erenozgurdogan/HighGain_DC-DC_Converter/Images/ExperimentalResults/experimentalresult.png

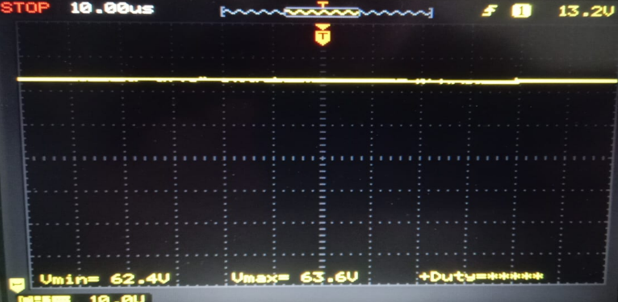
Images/ExperimentalResults/experimentalresult.png
