erenozgurdogan/HighGain_DC-DC_Converter/reports/erenozgur_dogan_2020502022.pdf

T.C.
DOKUZ EYLUL UNIVERSITY
ENGINEERING FACULTY
ELECTRICAL & ELECTRONICS ENGINEERING DEPARTMENT

## AN IMPROVED NON-ISOLATED QUADRATIC

## DC–DC BOOST CONVERTER WITH ULTRA

## HIGH GAIN ABILITY

### Fall Semester Report

by

### Eren Özgür DOĞAN

## Advisor

### Prof. Dr. Eyüp Akpınar

December, 2024

IZMIR

### TABLE OF CONTENTS

### 1.1 Enhanced Renewable Energy and Voltage Gain Improvement with Power Electronics .4

### ÖZET

Bu raporda, izole olmayan bir karesel yükseltici dönüştürücü tanıtmaktadır. "İzole

olmayan" terimi, giriş ve çıkış arasında elektriksel bir izolasyonun bulunmadığını ifade eder,

bu da devreyi daha basit ve verimli hale getirirken, güvenliği azaltır. "Karesel" terimi, giriş ve

çıkış gerilimi arasındaki ilişkiyi ifade eder ve bu parametrik ilişki içerisinde kareli bir çalışma

döngüsü vardır. Önerilen dönüştürücü, giriş gerilimini yükselten bir devrenin ardışık olarak

kurulumu yapısını kullanmadan ultra-yüksek çıkış gerilimi kazancını tek ve bütünleşik bir

devre yapısı ile elde etme özelliğine sahiptir. Düşük bir çalışma döngüsü ile yüksek çıkış

gerilim kazancı sağlar. Devre içerisinde bulunan kapasitörler, diyotlar ve yarı iletken

anahtarlar üzerinde gerilim stresini azaltılmaktadır. Ayrıca, sürekli kaynak akımı (CSC) ve

giriş-çıkış tarafı toprak paylaşımı özellikleri, yenilenebilir enerji uygulamaları için de

uygulamada | avantajlar sağlar. | Dönüştürücünün performansı, benzer topolojilerle

karşılaştırılmış ve teorik performans analizi yapılmıştır. Matlab/Simulink'ten elde edilen

simülasyon sonuçları, parametrik eşitliklerden çıkarılan teorik sonuçlarla karşılaştırılmıştır.

### ABSTRACT

This report introduces a non-isolated quadratic boost converter. The term "non-isolated"

indicates that there is no electrical isolation between the input and output, which simplifies the

circuit and increases efficiency while reducing safety. The term "quadratic" refers to the

relationship between the input and output voltage, characterized by a squared duty cycle within

this parametric relationship. The proposed converter achieves ultra-high output voltage gain

with a single and integrated circuit structure, without the sequential setup of circuits that step

up the input voltage. It provides high output voltage gain with a low duty cycle. Voltage stress

on the capacitors, diodes, and semiconductor switches within the circuit is reduced.

Additionally, features such as continuous source current (CSC) and input-output ground

sharing offer practical advantages for renewable energy applications. The converter's

performance has been compared with similar topologies, and a theoretical performance

analysis has been conducted. Simulation results obtained from MATLAB/Simulink have been

compared with theoretical results derived from parametric equations.

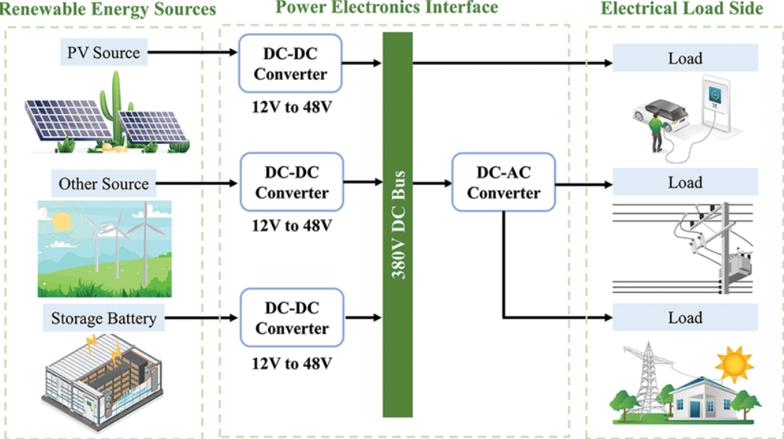
[picture p2: figure]

Figure 1 Power Electronics Interface

### 1. INTRODUCTION

### 1.1 Enhanced Renewable Energy and Voltage Gain Improvement with Power

Electronics

The excessive consumption of fossil energy sources leads to an increase in harmful gases

and climate change. This situation has led to a greater focus on renewable energy sources and

strengthened the need for sustainable energy solutions. Power electronics and converter

technologies are key tools that support this transition, ensuring that power obtained from

renewable energy sources is transferred efficiently to the energy grid.

The most fundamental topologies of boost and buck-boost converters can increase the low

input voltage to the required level using pulse width modulation (PWM) control. However,

conventional topologies cannot meet the voltage boosting requirements of real-time

applications. To achieve higher voltage gain, converters must operate at a high duty cycle.

However, this leads to an increase in voltage stress on the circuit components.

DC-DC boost converters can be classified into isolated and non-isolated types. Isolation is

typically achieved via a transformer, which increases the system's safety, but also makes the

system more complex, bulky, and costly.

The proposed circuit features CSC (Continuous Source Current) and SG (Shared

Ground) properties. CSC means that the input current in the circuit is continuous and stable,

which ensures more stable and efficient operation of the system. SG refers to the common ground connection shared by all components in the circuit, which enhances both safety and

efficiency.

The main features of the proposed topology are as follows:

Ultra-high voltage gain with low voltage stress on the devices.

CSC and SG features.

Same PWM used for both switches ,resulting in simpler control.

Fewer components and lower voltage stress compared to other ultra-high gain topologies.

### 2. METHOD

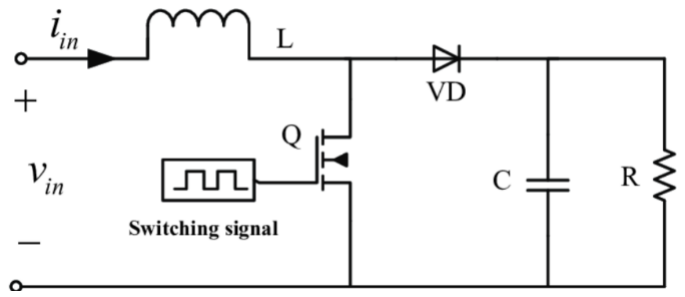
[picture p3: figure]

Figure 2.1 Conventional topology”

### 2.1 Switch (MOSFET) ON State

When the switch (MOSFET) is ON, the input voltage is applied to the inductor. This causes

the magnetic field in the inductor to increase and energy to be stored in the inductor. Current

flows only through the inductance. The magnetic field in the inductor converts electrical

energy into magnetic energy. During this time, the current in the inductor increases at a

constant rate, as the inductor opposes the change in current (L diI/dt).

### 2.2 Switch (MOSFET) OFF State:

When the switch is turned OFF, the MOSFET is deactivated and the inductor is removed

from the circuit. The magnetic field in the inductor tends to collapse, releasing the energy it

has stored. Due to the high inductance, the change in current is opposed, preventing an abrupt

change, and causing the magnetic field to start collapsing. As the magnetic field collapses, the stored energy in the inductor is directed through the diode to the output. While the current

decreases slowly, there are voltage changes during this process. The current is released from

the inductor and decreases gradually through the conduction of the diode.

Each component in the circuit has a specific function.

Diode: When the switch is OFF, the diode allows current to flow only towards the output,

thereby directing the stored energy to the output. This prevents reverse current flow and

ensures that energy from the inductor is released in the correct direction.

Capacitor: The capacitor reduces voltage fluctuations at the output and stabilizes the

output voltage. It smoothens the variations by storing and releasing energy, helping to maintain

a more consistent voltage.

Switch (MOSFET or Transistor): Typically, a MOSFET or transistor is used as a switch

in the circuit. When the switch is ON, it allows current to flow through the inductor, storing

energy in its magnetic field. When the switch is OFF, it stops the current, and the inductor

releases its stored energy to the output through the diode.

The output voltage for the boost converter depends only on the input voltage and duty cycle

Vout =

Vin
1−D

D =

Ton
Ton+Toff

Duty cycle is controlled by microcontrollers. Microcontrollers generate PWM (Pulse Width

Modulation) signals and adjust the operating times of the switches, thus controlling the duty

cycle. Ton refers to the time the switch is conducting, while Toff refers to the time the switch

is off. Ton+ Toff constitutes one period.

In a traditional boost converter, a high duty cycle must be set to achieve high voltage gain.

However, a high duty cycle leads to lower efficiency, higher voltage stress, and instability and

insecurity at high voltages. Therefore, more modern topologies are preferred over traditional

ones.

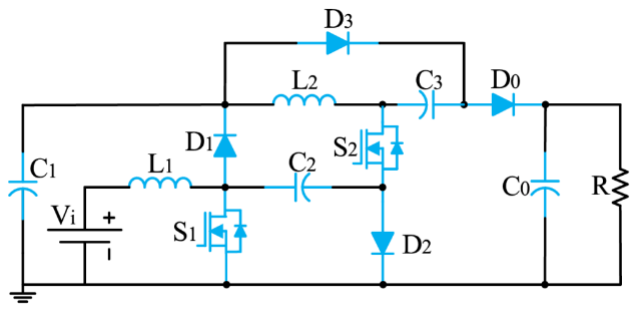
[picture p4: figure]

Figure 2.2 Proposed converter

The proposed converter achieves ultra-high gain without VDC with 12 components in Figure 2.2[1]. Compared with other topologies, the proposed converter achieves the desired output voltage with lower duty cycle, lower voltage stress and fewer components.

### 3. PROGRESS UP TO DATE

### 3.1 A.Mode-I (On) Operation

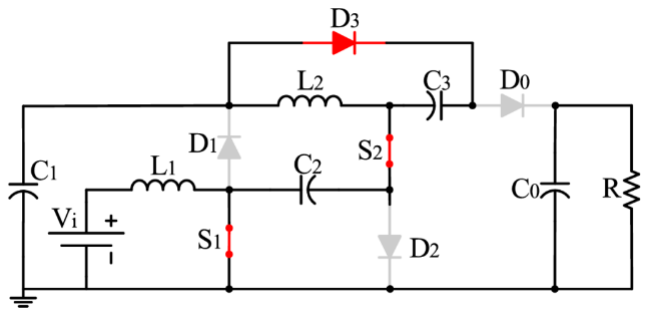
[picture p5: figure]

Figure 3.1 Proposed Converter Mode 1

By applying a positive Vgs voltage to the gate terminals of switches S1 and S2, the switches

turn ON in the circuit in Figure 2.3[1]. In this mode, L1 and L2 store energy, and the inductor

currents increase with the energy from C1 and C2. D1, D2, and D0 are in cutoff due to reverse

polarization, while D3 is conducting. During this period, since D0 is in cutoff, the load is

supplied by C0.

In this mode, the following equations are derived using Kirchhoff's Voltage Law.

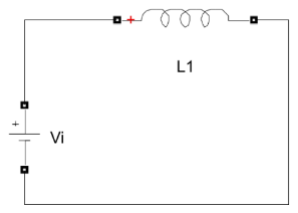
[picture p6: figure]

Figure 3.2 Loop 1 for Mode 1

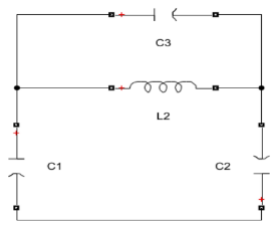
[picture p7: figure]

Figure 3.3 Loop 2 for Mode 1

VL2 = L2

dIL2
dt = VC3
V | (1) L1 = L1

dIL1
dt = Vi

VC1 + VC2 = VC3

### 3.2 B.Mode II (OFF) Operation:

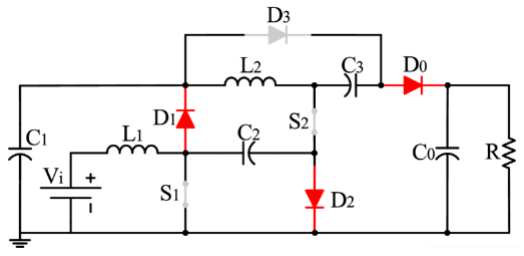
[picture p8: figure]

Figure 3.4 Proposed Converter Mode 2

The mode-II operation of the proposed converter is analyzed by following the equivalent

circuit shown in Figure 3.4 [1]. During this time, both switches are off, and diodes D1, D2,

and D0 become activated due to the forward-biased condition. The stored energy is now

transferred to the load by capacitors C1 and C2. During this period, diode D0 becomes

forward-biased, and capacitor C3 delivers energy to the output circuit.

In this mode, the following equations are derived using Kirchhoff's Voltage Law.

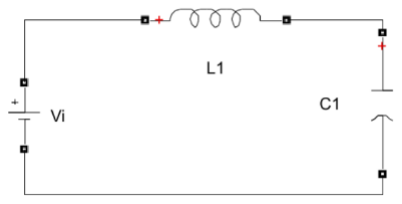
[picture p9: figure]

Figure 3.5 Loop 1 for Mode 2

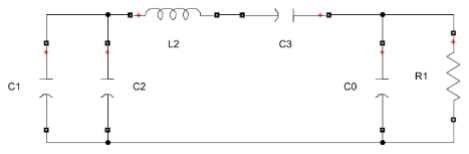
[picture p10: figure]

Figure 3.6 Loop 2 for Mode

VL1 = L1

dIL1
dt = Vi − VC1

VL2 = L2

dIL2
dt = VC1 + VC3 − VC0

(2)

VC1 = VC2

### 3.3 Voltage Gain Equation

According to the steady state condition, the average voltage across the inductor is zero over

one period. Using this condition, the voltage gain can be calculated.

D ⋅ T ⋅ Vi + (1 − D) ⋅ T ⋅ (Vi − VC1

) = 0 | (3)

D ⋅ T ⋅ VC3 + (1 − D) ⋅ T ⋅ (VC1 + VC3 − VC0

) = 0 | (4)

By using(1),(2),(3),and(4), the following expressions are derived for the voltage equations

of capacitors C1 ,C2,and C3.

VC1 = VC2 =

1
1 − D

⋅ Vi

(5)

VC3 = VC1 + VC2 =

2
1 − D

⋅ Vi

(6)

Finally, the mathematical expression of the voltage gain for the proposed converter comes

out with the help of equations (3),(4),(5),and (6),which can be expressed as follows

M =

VC0
Vi

=

V0
Vi

(3 − D)
(1 − D)

2

(7)

V0 =

(3 − D)
(1 − D)

2

⋅ Vi

(8)

### 3.4 Voltage Stress Calculation

Voltage stress is the maximum reverse voltage that a component experiences. This voltage

should be compared to the maximum limit the component can withstand. If the voltage stress

exceeds the maximum voltage the component can handle, it can cause damage to the

component.

Voltage stress for S1: S1 conducts in the ON mode and no voltage stress occurs on it. In the

OFF state, one end of S1 is grounded and the other end is at VC1 voltage. Therefore, the voltage

stress for S1 is VC1.

Voltage stress for S2: S2 conducts in the ON state and no voltage stress occurs on it. In the

OFF state, one end of S2 is at VC0 voltage and the other end is at VC3 voltage. Therefore, the

voltage stress for S2 is VC0 - VC3.

Voltage stress for D3: In the OFF state, one end of D3 is at VC0 and the other end is at VC1.

Therefore, the voltage stress on D3 is the VC0 - VC1 voltage.

Voltage stress for D1: In the OFF state, one end of D1 is grounded and the other end is at

VC1. Therefore, the voltage stress on D1 is VC1.

Voltage stress for D2: In the OFF state, one end of D2 is grounded and the other end is at

VC2. Therefore, the voltage stress on D2 is VC2.

Voltage stress for D0: In the OFF state, one end of D0 is at VC1 and the other end is at VC0.

Therefore, the voltage stress on D0 is VC0 – VC1

VS1 = VC1 =

1
(1−D)

⋅ Vi

VS2 = VC0 − VC3 =

1+D
(1−D)

2

⋅ Vi
(9)

VD3 = VD0 = VC0 − VC1 =

2
(1−D)

2

⋅ V

VD2 = VD1 = VC1 =

1
(1−D)

⋅ V

In the lossless condition, the input power should be equal to the output power. With this

condition, the relationship between the input current and the output current can be found.

Pi = P0
Ii
I0

=

V0
Vi

= M =

(3 − D)
(1 − D)

2

Ii = IL1 =

(3 − D)
(1 − D)

2

I0

(10)

IL1 =

(3 − D)
(1 − D)

2

I0

The current of L2 is reflected to the output only in Mode 2, that is, during (1-D)T. Therefore,

the relationship between IL2 and Io.

IL2 =

1
(1 − D)

I0

(11)

### 3.5 Design Of The Components

The value for the inductor and capacitor can be determined with the help of the parameters

D, fs,Vi,V0,and their mathematical expressions can be written as,

L1 =

ViD
ΔIL1fs

L2 =

2VC1D
ΔIL2fs

(12)

C1 = C2 =

IC1

(1 − D)
ΔVC1fs

C3 =

IC3

(1 − D)
ΔVC3fs

### 3.6 Boundary Condıtıon

The boost converter can operate in three different modes depending on the inductor current

state.

These modes are continuous conduction mode (CCM), discontinuous conduction mode

(DCM), and boundary conduction mode (BCM).

Continuous Conduction Mode (CCM): The inductor current is continuously positive.

Discontinuous Conduction Mode (DCM): The inductor current drops to zero, stays at

zero for a while, and then increases again.

Boundary Conduction Mode (BCM): It is the transition state between CCM and DCM.

The inductor current drops to zero but immediately increases again.

τ > τB: CCM mode

τ < τB: DCM mode | (13)

τ = τB: BCM mode

τ1 =

2L1fs
R
(14)

τ2 =

L2fs
R

τB1 =

D(1−D)

4
3−D
(15)

τB2 =

D(1−D)

4
3−D

IL1 =

(3 − D)I0
(1 − D)

2

ΔIL1 =

ViD
L1fs

IL1

(min) = IL1 −

ΔIL1
2

(16)

L1 ≥

D(1−D)

4R
2(3−D)fs

IL2 =

I0
(1−D)
ΔIL2 =

2VC1D
L2fs

L2

(min) = IL2 −

ΔIL2
2

(17)

L2 ≥

D(1−D)

2R
(3−D)fS

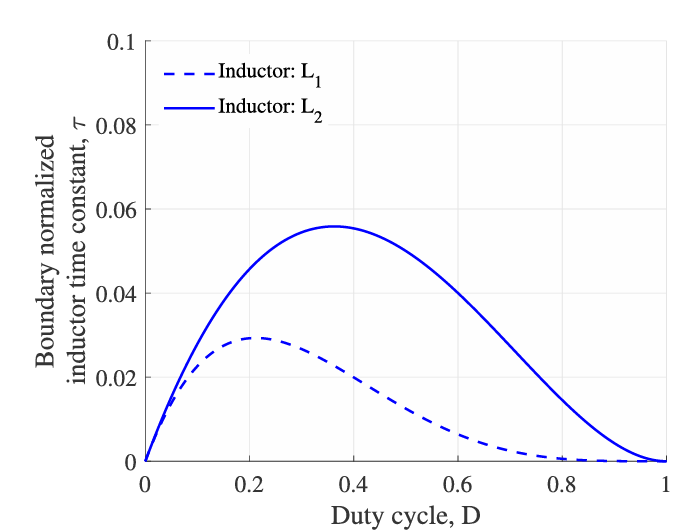
[picture p11: figure]

Figure 3.7 Boundary Conditions Curve

The relationship between duty cycle and boundary normalized inductor time constant is

shown in the graph in Figure 3.7 [1]. If there is more than one inductor, separate mode control

is applied for each.

### 3.7 Discontinuous Conduction Mode Of Proposed Converter

DCM mode occurs when the inductor current falls to zero. For the proposed converter,

there are three states in DCM operation. In Mode I (0 < t < DTS), S1 and S2 are in the ON

state. DCM and CCM are the same in this range. The maximum inductor current during this

interval can be written.

IL1

(peak) =

Vi
L1
⋅ DT | (18)

IL2

(peak) = VC3 = 2VC1 =

2Vi
(1 − D)L2
DT | (19)

In Mode II (DTs < t < DaTs), the S1 and S2 switches turn OFF. The magnetic field of the

inductors is disrupted, and the inductor current reaches zero. The maximum current of L2 can

be expressed in terms of Da.

IL2

(peak) =

3Vi − V0

(1 − D)
(1 − D)L2

DaT

(20)

In Mode III (DaTs < t < Ts), both switches remain in the OFF state, and no current flows

through the inductors. During this period, the load current is supplied by the C0 output

capacitor. The DCM voltage gain, ICO, and Da can be calculated. DCM mode is shown in

figure 3.8 [1].

Da =

2ViD
3Vi − V0

(1 − D)

(21)

IC0 =

1
2DaIL2

(peak)

− I0

(22)

IC0 =

2Vi

2D
2TS
[3Vi − V0

(1 − D)](1 − D)L2

− I0

(23)

MDCM =

1
2(1−D)

[3 ±

√9τL2L2+4D²

τL2

]
(24)

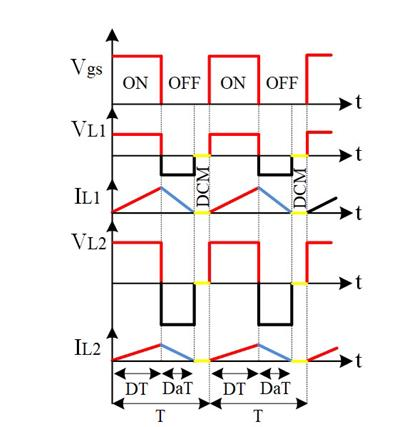
[picture p12: figure]

Figure 3.8 Waveform for DCM

### 3.8 Non-Ideal Voltage Gain Of Proposed Converter

For the ideal proposed converter, the gain increases as the duty cycle (D) increases.

However, the situation is different for the non-ideal case. In the non-ideal case, the maximum

voltage gain is achieved at D = 0.72. If the duty cycle (D) is increased further, the voltage gain

decreases. This situation arises from factors such as the MOSFET resistance, the forward

voltage of the diodes, the inductor resistance, and the energy storage and release capabilities.

If D is greater than 0.72, the influence of non-ideal factors increases, and the voltage gain

decreases.

### 3.9 Simulation Results

If Vi =12V, f=10kHz, and D=0.4 are set in the circuit, then according to the theoretical

equations, Vo =86.6V will be obtained.

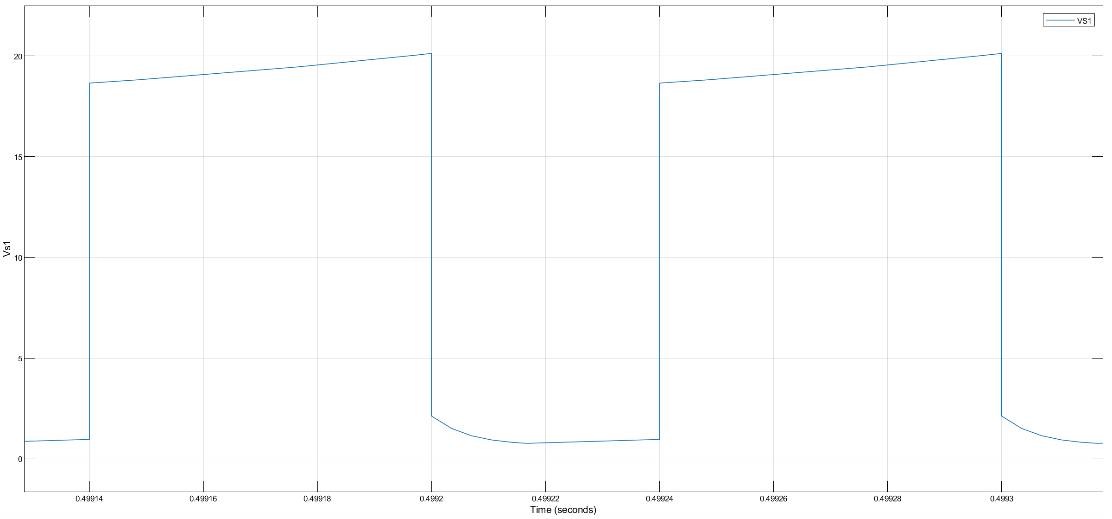
[picture p13: figure]

Figure 3.9 VS1

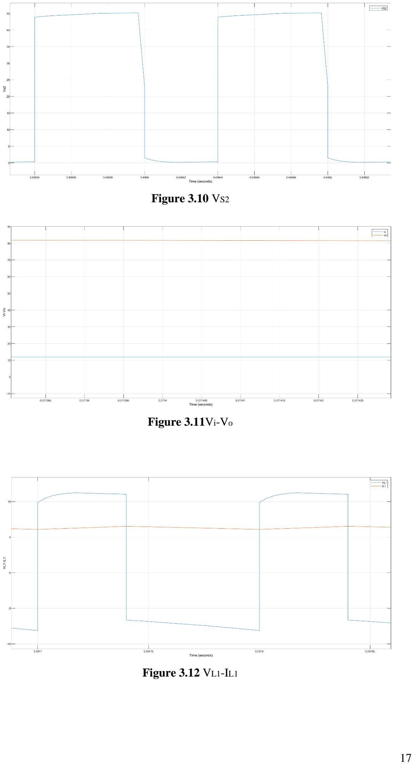
[picture p14: page 17]

Figure 3.10 VS2

Figure 3.11Vi-Vo

Figure 3.12 VL1-IL1

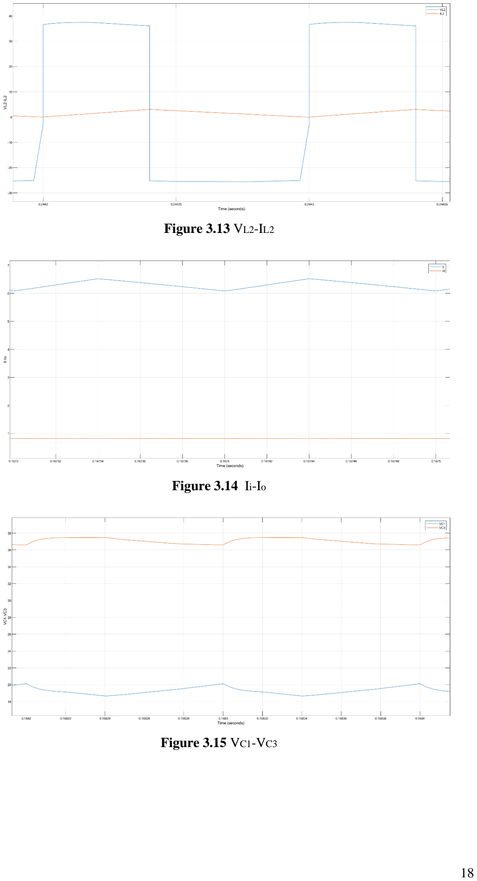
[picture p15: page 18]

Figure 3.13 VL2-IL2

Figure 3.14 Ii-Io

Figure 3.15 VC1-VC3

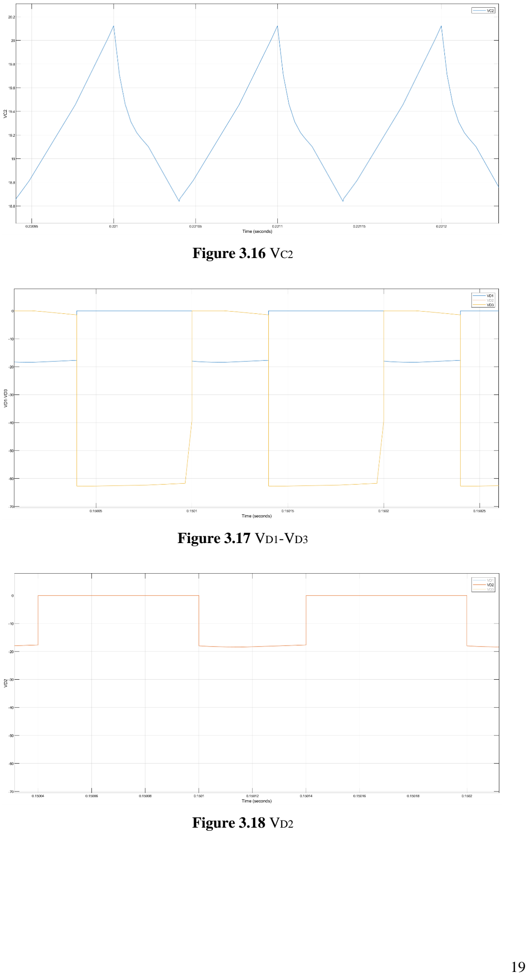
[picture p16: page 19]

Figure 3.16 VC2

Figure 3.17 VD1-VD3

Figure 3.18 VD2

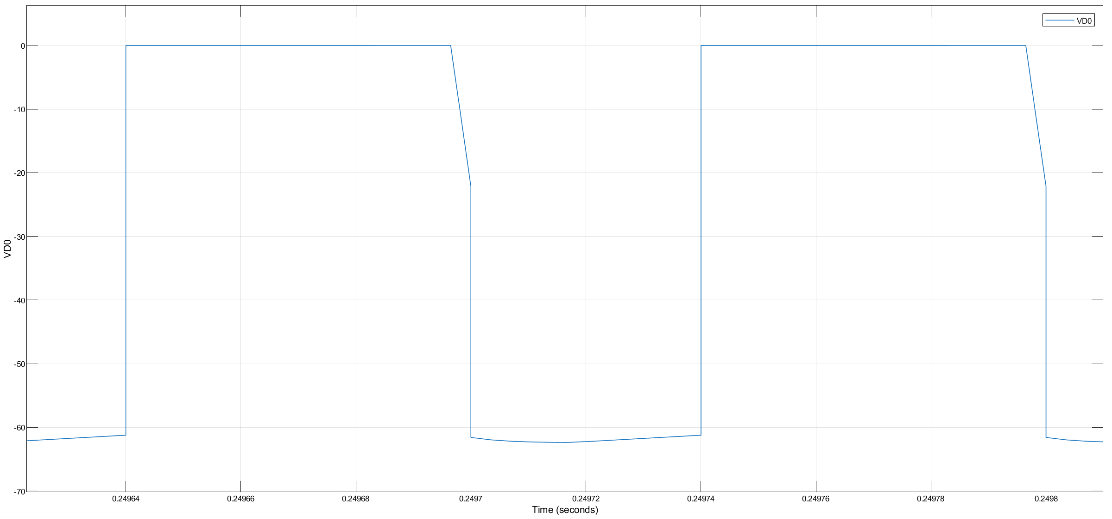
[picture p17: figure]

Figure 3.19 VDo

It can be observed that the simulation results match the theoretical results for D=0.4

f=10kHz ,Vi=12V.

To examine the effect of duty cycle and frequency on Vo , different duty cycles and

frequencies should be applied to the circuit.

Effect of Duty Cycle (D) on Vo:

D=0.1 f=10kHz V0=41.3 V theoretically Vo=42.96

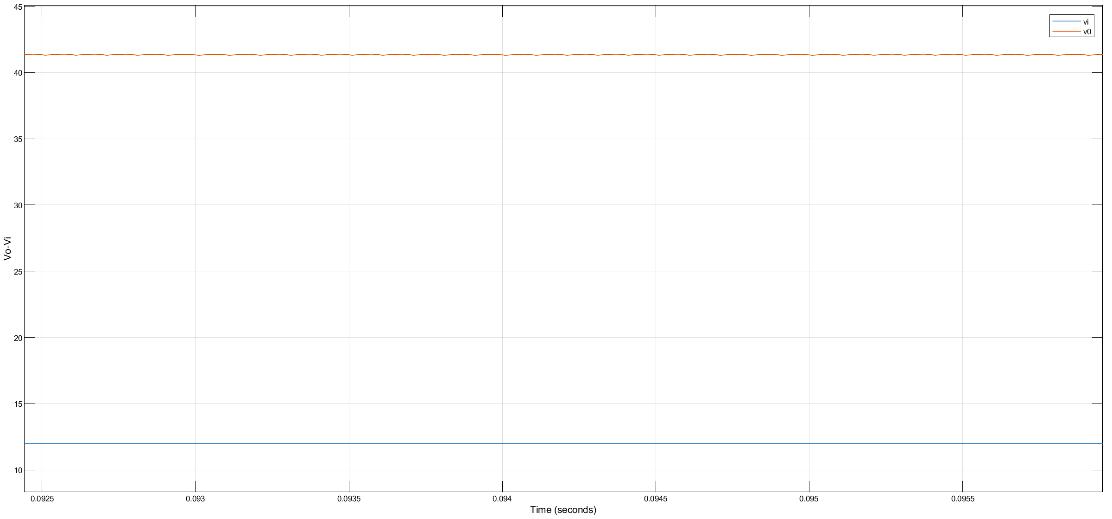
[picture p18: figure]

Figure 3.20 V0 graph at D=0.1

D=0.2 f=10kHz Vo=50.5 V theoretically Vo= 52.5 V

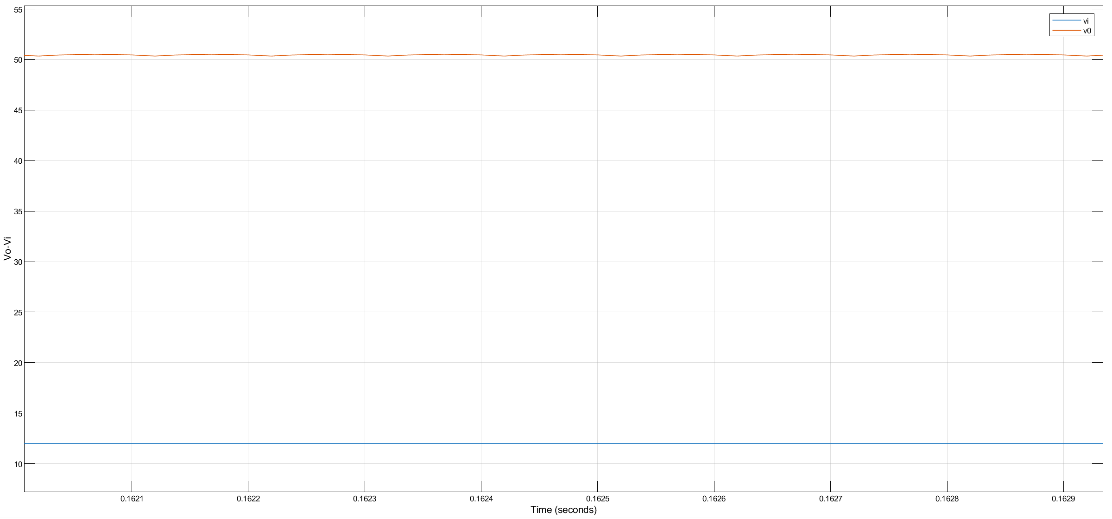
[picture p19: figure]

Figure 3.21 V0 graph at D=0.2

D=0.3 f=10kHz Vo=63.5 V theoretically Vo =66.12 V

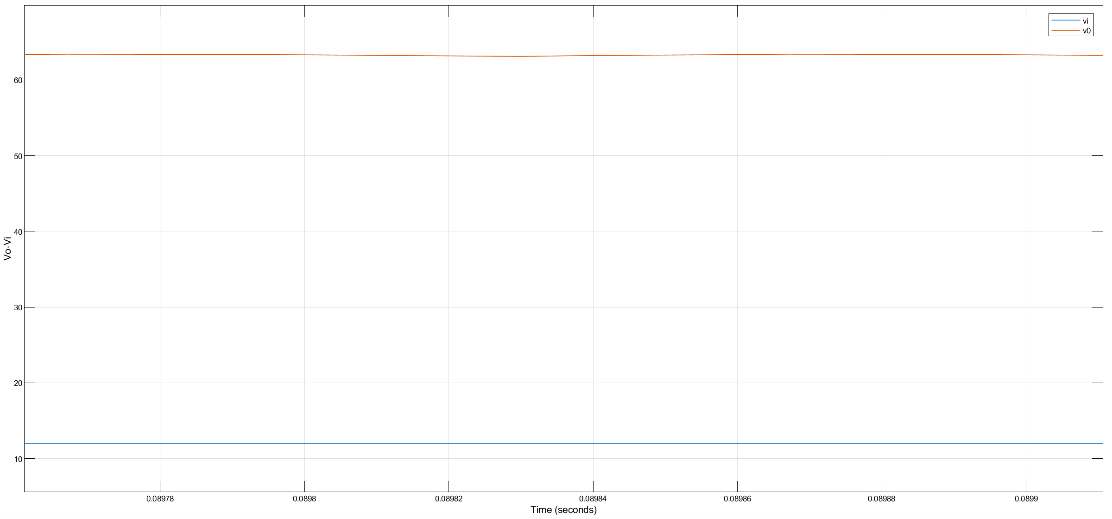
[picture p20: figure]

Figure 3.22 V0 graph at D=0.3

D=0.4 f=10kHz Vo=83.5 V theoretically Vo=86.12 V

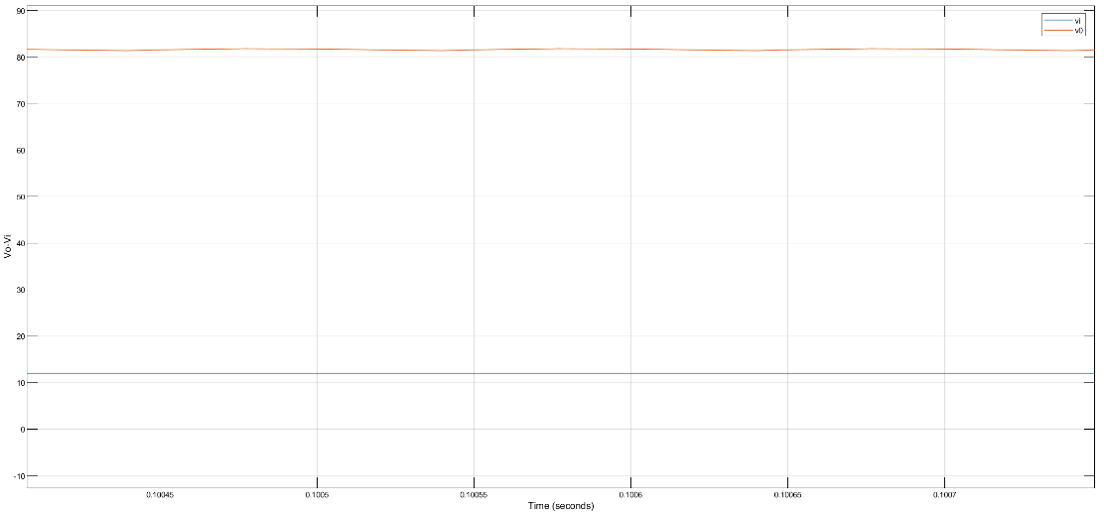
[picture p21: figure]

Figure 3.23 V0 graph at D=0.4

D=0.5 f=10kHz Vo=107.3 V theoretically Vo=120 V

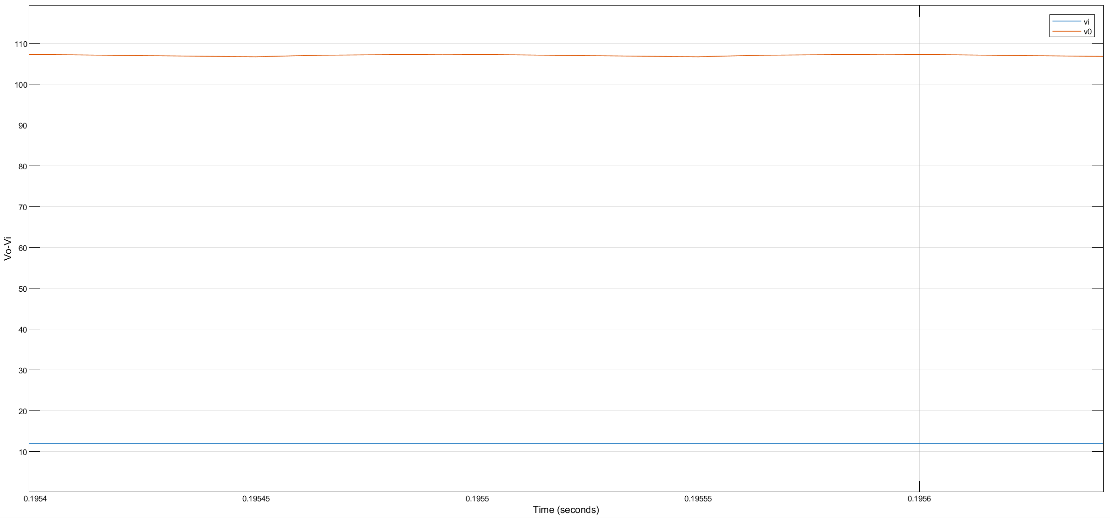
[picture p22: figure]

Figure 3.24 V0 graph at D=0.5

D=0.6 f=10kHz Vo=144 V theoretically Vo=180 V

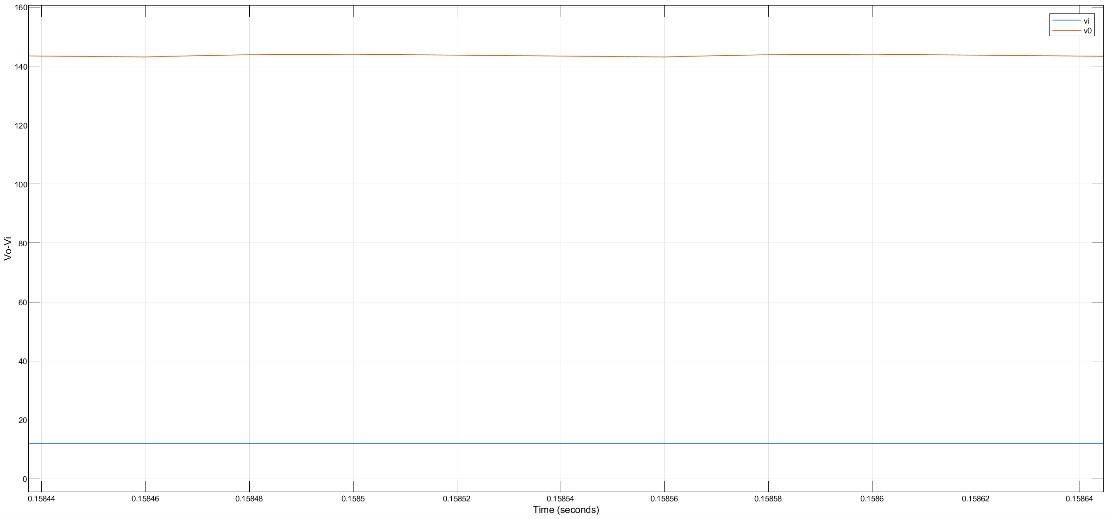
[picture p23: figure]

Figure 3.25 V0 graph at D=0.6

D=0.7 f=10kHz Vo=180 V theoretically Vo=306.6

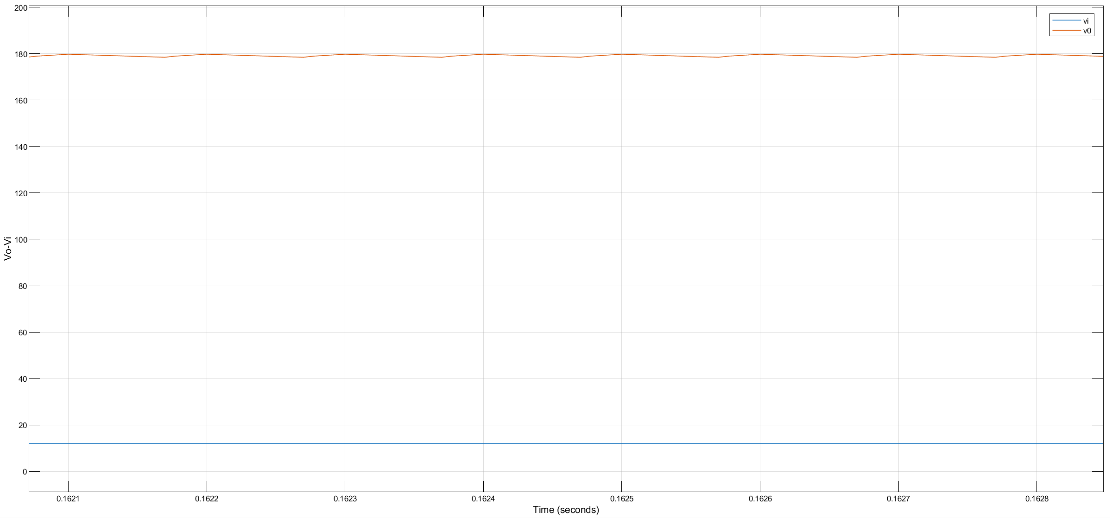
[picture p24: figure]

Figure 3.26 V0 graph at D=0.7

The output voltage is directly proportional to the duty cycle and is consistent with the

theoretical results up to a certain point. However, after a specific duty cycle, the converter

does not operate as expected.

The proposed converter generates the desired output voltage for duty cycles between D=0.6

and D=0.65. However, after D=0.65, it produces a lower output voltage than desired. This

indicates that the converter should ideally be operated with a maximum duty cycle of D=0.65.

Effect of Frequency on Vo:

D=0.4 f=10kHz V0=83.5 theoretically V0=86.6

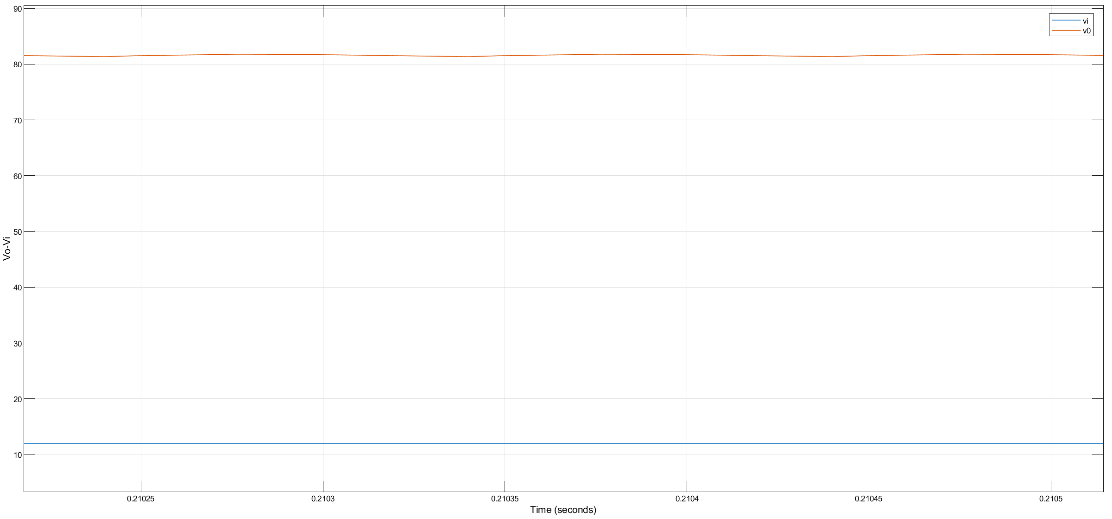
[picture p25: figure]

Figure 3.27 V0 graph at f=10kHz D=0.4

D=0.4 f=20 kHz V0=83.5 theoretically V0=86.6

Figure 3.28 Vo graph at f=20kHz D=0.4

D=0.4 f=50kHz V0=83.5 theoretically V0=86.6

Figure 3.29 V0 graph at f=50kHz D=0.4

D=0.4 f=100kHz V0=83.5 theoretically V0=86.6

Figure 3.30 V0 graph at f=100kHz D=0.4

The frequency has no effect on the duty cycle, and therefore, it has no effect on Vo . This

is because the voltage gain equation depends solely on the duty cycle.

The effect of frequency is on the selection of circuit components L1,L2,C1,C2,C3,

particularly in determining the minimum values for L1 and L2.

4.WORK PLAN FOR SPRING SEMESTER

Week 1-2: PWM Signal Generation with STM32F04

During the first two weeks, the focus will be on PWM (Pulse Width Modulation) signal

generation using the STM32F04 microcontroller. This phase involves familiarizing with the

basic features of the microcontroller and generating PWM signals via software. The process

will include calculations to obtain the correct signal frequency and amplitude, and writing

the appropriate code to generate the PWM signal.

Week 2-6: PCB Design, Assembly, and Circuit Testing

Starting from week 2, PCB design and assembly will be carried out. During this period,

the components required for the circuit will be selected, and the PCB will be designed. After

the design, the PCB will be produced and the components will be assembled onto the board.

After the assembly, the circuit testing phase will begin. In this phase, the functionality of

the components and connections on the PCB will be verified, and if any errors are detected,

they will be addressed. This phase is crucial for verifying the accuracy and functionality of

the physical design.

Week 8-10: Comparison with Simulation Results

At the end of week 6, after the circuit assembly, simulation results will be obtained. This

phase involves performing theoretical and simulation-based analyses. The results will then

be compared with the real-world test results to assess how accurate the simulation is and how

closely the physical circuit matches the simulated behavior. This comparison will help

identify any discrepancies between the simulation and the actual performance of the circuit

and provide insights into potential improvements.

Week 10-12: Troubleshooting and Improvement

Based on the results from the simulation and testing, troubleshooting and improvements

will be made in weeks 10-12. Any issues identified in the system will be resolved, and

necessary corrections will be made either in the hardware or software. This phase aims to

ensure that the system operates in a more stable and efficient manner. Troubleshooting may

include reviewing the compatibility of the components used in the hardware and optimizing

the software code.

Week 12-14: Report Generation

In the final two weeks of the project, all the collected data, test results, and improvements

will be thoroughly analyzed and documented in a final report. This report will include a

detailed summary of the entire project process, the results of the tests conducted, and any

challenges encountered during the project. Additionally, the comparison between the

simulation and real-world results, as well as the solutions implemented, will be discussed in

the report. This phase will conclude the project by providing a formal summary of all the

work done.

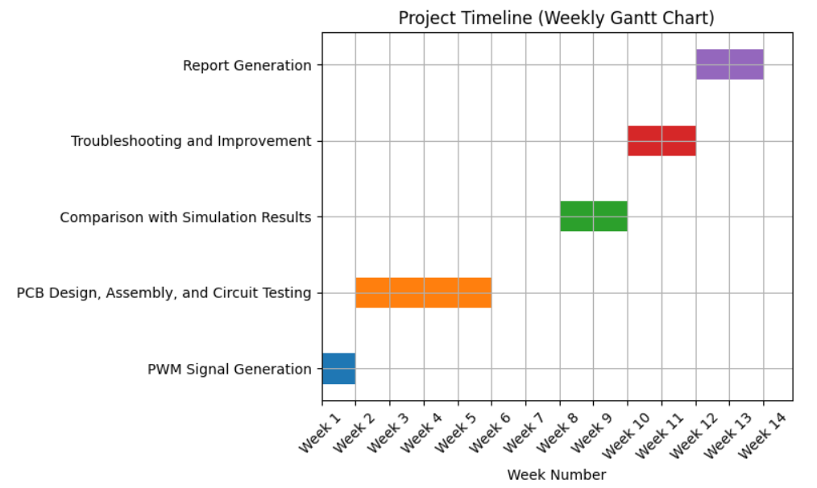
[picture p26: figure]

Figure 4.1 Gantt Table for Project

### 5. COST ANALYSIS

Cost Analysis for the Boost Converter Circuit

This section outlines the cost analysis of the components used in the design of the boost

converter circuit. Below are the prices for each component and the total cost calculation.

Used Components and Their Prices:

### 2 Inductors:

Inductors are used for energy storage in power conversion circuits. The total cost for the 2

inductors used in this circuit is 20 TL.

### 4 Capacitors:

Capacitors are used for energy storage and filtering. The total cost for 4 capacitors is 5 TL.

### 1 Resistor:

A resistor is a basic component used to limit current. The cost for 1 resistor is 1 TL.

### 2 MOSFETs:

MOSFETs are used as switching elements. The total cost for the 2 MOSFETs in this circuit is

500 TL. The cost of MOSFETs is significant, especially in high-power applications.

### 4 Diodes (Mur840):

Diodes are used to allow current flow in one direction. The total cost for 4 Mur840 diodes is

100 TL.

### 2 Gate Drivers (TLP250):

Gate driver ICs are necessary for the proper operation of MOSFETs. The total cost for 2

TLP250 gate driver ICs is 100 TL.

### 2 STM32 Microcontrollers:

Microcontrollers are used to control the circuit. The total cost for 2 STM32 microcontrollers

is 2000 TL. The price of the STM32 can vary depending on the complexity of the application.

PCB Manufacturing:

The PCB is where all the components are placed and interconnected. The total cost for PCB

manufacturing is 2000 TL.

The total cost for the components and PCB manufacturing for the boost converter circuit is

4726 TL. This cost reflects the price of the main components needed to design and produce

the circuit.

### 6. CONCLUSIONS

In this study, the application areas and operating principle of the boost converter have been

explained in detail. Traditional boost converters generally fail to provide the desired gain in

real-life applications. This has led to the development of more advanced and efficient boost

converters. The operating principle of the proposed converter has been described, and the

parameters used in the design have been validated to ensure optimal performance.

Additionally, the proposed converter was compared with other advanced boost converters, and

its advantages in terms of efficiency and performance were emphasized.

A significant part of the study relied on circuit simulation performed using MATLAB-

Simulink. The simulation results were compared with theoretical calculations, and a high

degree of consistency between the two was observed. These results demonstrate the

effectiveness of the proposed design in real-world applications.

However, a disadvantage of the proposed converter is the need for two separate controllers,

which increases the complexity of the system. Future work will focus on designing the circuit

to operate with a single controller, which could simplify the design and enhance overall

efficiency. Furthermore, optimizing the circuit components to reduce losses and further

improve performance will be a key area for future development.

### 7. REFERENCES

[1]An Improved Non-Isolated Quadratic DC–DC Boost Converter With Ultra High Gain

Ability NAFIS SUBHANI 1,ZAZILAH MAY 2,(Graduate Student Member, IEEE), MD.

KHORSHED ALAM, IRFAN KHAN 4,(Senior Member, IEEE), MD. ALAMGIR HOSSAIN

5, AND SABRINA MAMUN 6

[2]S. V. K. Naresh, S. Peddapati, and M. L. Alghaythi, ‘‘Non-isolated high gain quadratic

boost converter based on Inductor’s asymmetric input volt age,’’ IEEE Access, vol. 9, pp.

162108–162121, 2021

[3]T.Rahimi,L.Ding,H.Gholizadeh,R.S.Shahrivar,andR.Faraji,‘‘Anultra high step-up DC–

DC converter based on the boost, Luo, and voltage dou bler structure: Mathematical

expression, simulation, and experimental,’’ IEEE Access, vol. 9, pp. 132011–132024, 2021.

[4]K. Yari, S. H. Shahalami, and H. Mojallali, ‘‘A novel nonisolated buck boost

converter with continuous input current and semiquadratic volt age gain,’’ IEEE J. Emerg.

Sel. Topics Power Electron., vol. 9, no. 5, pp. 6124–6138, Oct. 2021.

[5]. Veerachary and M. R. Khuntia, ‘‘Design and analysis of two-switch based enhanced

gain buck–boost converters,’’ IEEE Trans. Ind. Electron., vol. 69, no. 4, pp. 3577–3587,

Apr. 2022.

[6]P. M. García-Vite, J. C. Rosas-Caro, A. L. Martínez-Salazar, J. D. J. Chavez, A.

Valderrábano-González, and V. M. Sánchez-Huerta, ‘‘Quadratic buck–boost converter with

reduced input current ripple and wide conversion range,’’ IET Power Electron., vol. 12, no.

15, pp. 3977–3986, Dec. 2019.

[7]M.VeeracharyandN.Kumar,‘‘Analysisanddesignof quadratic following boost

converter,’’ IEEE Trans. Ind. Appl., vol. 56, no. 6, pp. 6657–6673, Nov. 2020

[8]A. Mahmood, M. Zaid, J. Ahmad, M. A. Khan, S. Khan, Z. Sifat, C.-H. Lin, A.

Sarwar, M. Tariq, and B. Alamri, ‘‘A non-inverting high gain DC–DC converter with

continuous input current,’’ IEEE Access, vol. 9, pp. 54710–54721, 2021.

[9]R. Afzal, Y. Tang, H. Tong, and Y. Guo, ‘‘A high step-up integrated coupled inductor-

capacitor DC–DC converter,’’ IEEE Access, vol. 9, pp. 11080–11090, 2021

[10]P. Kumar and M. Veerachary, ‘‘Z-network plus switched-capacitor boost DC–DC

converter,’’ IEEE J. Emerg. Sel. Topics Power Electron., vol. 9, no. 1, pp. 791–803, Feb.

2021.

[11]S. Sadaf, M. S. Bhaskar, M. Meraj, A. Iqbal, and N. Al-Emadi, ‘‘A novel modified

switched inductor boost converter with reduced switch volt age stress,’’ IEEE Trans. Ind.

Electron., vol. 68, no. 2, pp. 1275–1289, Feb. 2021.

[12]N. A. Ahmed, B. N. Alajmi, I. Abdelsalam, and M. I. Marei, ‘‘Soft switching

multiphase interleaved boost converter with high voltage gain for EV applications,’’ IEEE

Access, vol. 10, pp. 27698–27716, 2022.
