erenozgurdogan/HighGain_DC-DC_Converter/reports/erenozgur_dogan_2020502022final.pdf

T.C.

DOKUZ EYLUL UNIVERSITY
ENGINEERING FACULTY

ELECTRICAL & ELECTRONICS ENGINEERING

DEPARTMENT

## AN IMPROVED NON-ISOLATED QUADRATIC

## DC–DC BOOST CONVERTER WITH ULTRA

## HIGH GAIN ABILITY

### Final Project

by

### Eren Özgür DOĞAN

## Advisor

### Prof. Dr. Eyup AKPINAR

June, 2024

İZMİR

i

### THESIS EVALUATION FORM

We certify that we have read this thesis and that in our opinion is fully adequte,in scope

and qualify as an undergraduate thesis,based on the result of the oral examination taken place

on 16/06/2025.

Prof.Dr. Eyup Akpınar

(Advisor)

Prof.Dr. Selçuk Kılınç | Assoc.Prof.Dr.Taner Göktaş
(Committee Member) | (Commitee Member)

Prof.Dr.Yavuz Şenol

(Chairman)

ii

ÖZET

Bu raporda, izolasyonsuz ve kazanç ilişkisi ikinci dereceden formülasyona sahip, ultra

yüksek gerilim kazancı sağlayabilen bir DC-DC yükseltici dönüştürücü tanıtılmaktadır. İzolasyonun olmaması, giriş ve çıkış arasında doğrudan elektriksel bağlantı bulunduğunu ifade

eder. Transformatör gibi izolasyon bileşenlerinin bulunmaması; daha basit devre yapısı, düşük

maliyet ve yüksek verimlilik sağlarken, güvenlik açısından bazı dezavantajlar oluşturur. Önerilen dönüştürücü, giriş gerilimini tek ve bütünleşik bir yapı ile, düşük görev döngüsünde

yüksek çıkış gerilimine dönüştürebilmektedir. Diğer topolojilere kıyasla, devre bileşenleri

üzerindeki gerilim stresi daha düşüktür. Ayrıca sürekli kaynak akımı (CSC) ve giriş-çıkış tarafı

ortak topraklama özellikleri sayesinde, yenilenebilir enerji uygulamaları için uygundur.

Prototip devre tasarlanarak gerekli testler gerçekleştirilmiş, farklı görev döngülerinde elde

edilen kazançlar hesaplanmış ve sonuçlar MATLAB/Simulink üzerinden yapılan

simülasyonlarla karşılaştırılmıştır.

iii

### ABSTRACT

This report introduces a non-isolated, quadratic-structured DC-DC boost converter capable of

providing ultra-high voltage gain. The lack of isolation means there is a direct electrical

connection between the input and output. The absence of isolation components such as

transformers results in a simpler circuit design, lower cost, and higher efficiency, but it also

brings some disadvantages in terms of safety. The proposed converter can convert the input

voltage to a high output voltage using a single, integrated structure at low duty cycles.

compared to other topologies, the voltage stress on circuit components is lower. Additionally,

it draws the continuous current from the input voltage source and the common ground on both

input and output sides exists, it is suitable for renewable energy applications. A prototype

circuit was designed, necessary tests were performed, gains obtained at different duty cycles

were calculated, and the results were compared with simulations conducted in

MATLAB/Simulink.

iv

### TABLE OF CONTENTS

### 5. THEORETICAL RESULTS, SIMULATION AND EXPERIMENTAL RESULTS 10

v

### LIST OF FIGURES

Figure 1.0.1 Power electronics block diagram | 1
Figure 2.1.1 STM32 microcontroller pin configuration | 2
Figure 2.2.1 Clock configuration of the STM32 | 3
Figure 2.3.1 STM32 TIM2 configuration | 4
Figure 2.4.1 STM32 TIM2 CCR configuration | 4
Figure 3.0.1 TLP 250 pin configuration | 5
Figure 3.0.2 Detailed circuit diagram | 6
Figure 4.0.1 Power supply circuit | 7
Figure 4.1.1 KBPC 35 bridge rectifier | 1
Figure 4.2.1 ASL102112 transformer | 9
Figure 4.2.2 KA 7812 linear voltage regulator | 9
Figure 5.1.1 Schematic diagram of the converter | 11
Figure 5.1.2 Theoretical Vo-Duty Cycle relationship with graph | 12
Figure 5.2.1 Simulation of the converter | 13
Figure 5.2.3 Simulated Vo-Duty Cycle relationship with graph | 11
Figure 5.3.1 Experimental Vo-Duty Cycle relationship with graph | 22
Figure 5.3.2 Prototype of the converter | 22

Figure 5.4.1 Vo-Duty Cycle relationship comparison of theoretical,simulation and

experimental results with graph | 23
Figure 5.5.1 Gain and Duty Cycles relationship with graph | 24
Figure 5.5.2 Experimental/Theoretical Results -Duty Cycle relationship with graph | 25

vi

### LIST OF TABLES

Table 5.1.1 Theoretical Vo-Duty Cycle relationship | 11
Table 5.2.1 Simulated Vo-Duty Cycle relationship | 13
Table 5.2.2 Simulated Vo-Duty Cycle relationship with graphs | 14
Table 5.3.1 Experimental Vo-Duty Cycle relationship | 11
Table 5.3.2 Experimntal Vo-Duty Cycle relationship with oscilloscope results | 19

Table 5.4.1 Vo-Duty Cycle relationship comparison of theoretical,simulation and

experimental results | 23
Table 6.0.1 Cost analysis | 25

1.INTRODUCTION

Nowadays, the importance of energy efficiency and renewable energy applications

is steadily increasing. In this context, DC-DC converters, which are used to obtain high voltage

from low-voltage DC sources, play a critical role in energy management and power

electronics. Boost converters are among the most common and effective converters for

stepping up input voltage, especially preferred in battery-supported systems and renewable

energy applications.

In this project, a boost converter prototype controlled by PWM signals generated

using an STM32 microcontroller was designed and implemented. Additionally, the power

supply required for the circuit was completely designed and developed. Thus, the performance

of both the converter and the power supply circuits was examined under real operating

conditions. Theoretical calculations from the gain between output and input voltages,

MATLAB/Simulink simulations, and experimental results of the converter were compared at

different duty cycles. The obtained results provide valuable data for evaluating the circuit’s

performance.

The primary aim of the project is to thoroughly investigate the behavior of the boost

converter in real applications and to validate theoretical and simulation results with

experimental data. This study aims to enhance practical knowledge in power electronics, both

in hardware design and control algorithms.

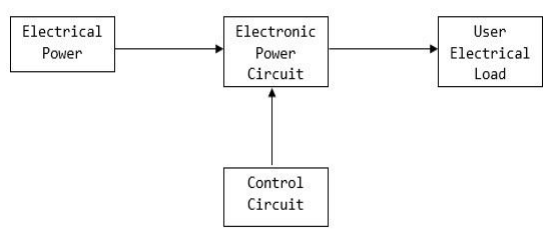
[picture p27: figure]

Figure 1.0.1 Power electronics block diagram

### 2. PWM SIGNAL GENERATION

In this project, an STM32 microcontroller was used to control the IGBT driver.

Thanks to its advanced timer modules, the STM32 generates precise PWM signals that control

the switching duration of the IGBT. These PWM signals enable voltage and current control in

the power circuit. Since the STM32 output voltage is 3.3 V, the PWM signal cannot be applied

directly to the IGBT gate. Therefore, the signal is amplified with an appropriate gate driver

circuit, and galvanic isolation is provided. The programmable structure and real-time control

capabilities of the STM32 allow the system to operate flexibly and reliably.

### 2.1 Timer and Pin Configuration

Timer 2 (TIM2) has been used for the PWM output. TIM2’s Channel 1 and Channel

2 output pins have been selected for the PWM signal. These pins are configured as PA0 and

PA1, respectively.

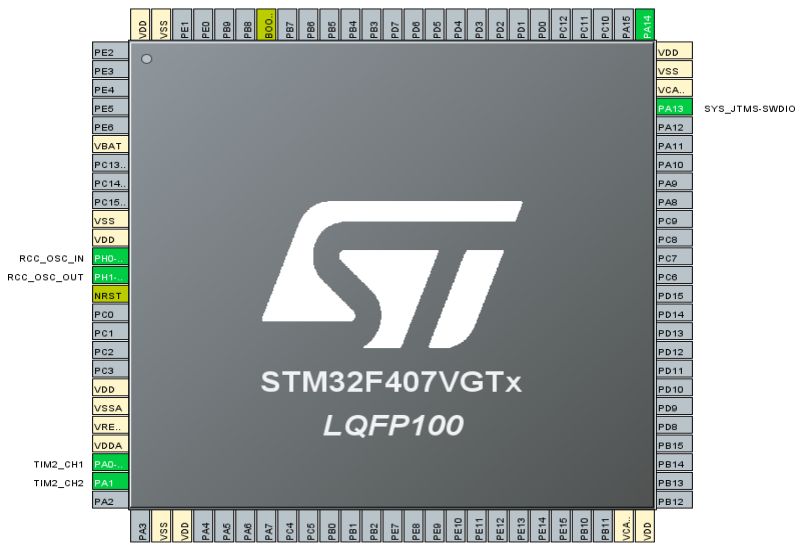
[picture p28: figure]

Figure 2.1.1 STM32 microcontroller pin configuration

### 2.2 Setting the Timer Clock Frequency

The APB1 timer clock frequency, which is the operating source of TIM2, is set to 8

MHz.

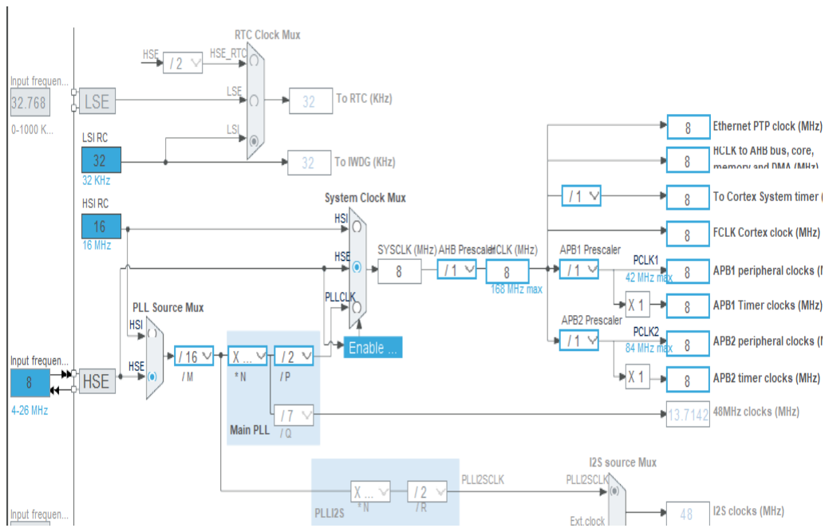
[picture p29: figure]

Figure 2.2.1 Clock configuration of the STM32

### 2.3 Calculation of the Prescaler Value

The timer clock is set to 8 MHz through the APB1 timer frequency. To achieve the

desired PWM frequency, appropriate prescaler and counter period values have been selected

using the equation (1). To achieve the desired PWM frequency, the counter period was set to

100, and the appropriate prescaler value was adjusted according to equation (1). The prescaler

divides the clock signal applied to the timer by a certain factor, slowing down the timer’s

counting speed. This reduces the timer’s operating frequency and allows more precise control

over timing operations. The counter period determines how many counts the timer completes

before resetting, which defines the PWM signal’s period and thus affects its frequency. By

adjusting both the prescaler and counter period values together, the desired PWM frequency

and resolution can be achieved.

Prescaler =

(Timer Frequency Period)
(PWM frequency∗Counter Period)

− 1 (1)

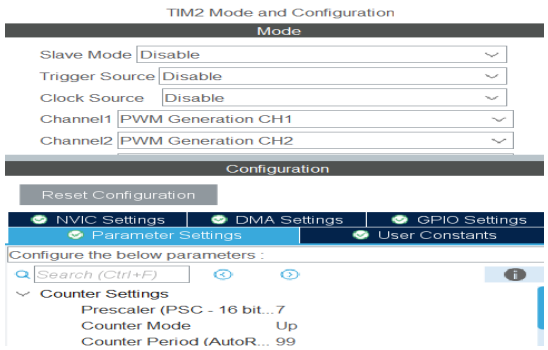
[picture p30: figure]

Figure 2.3.1 STM32 TIM2 PWM configuration

### 2.4. Duty Cycle Setting

The duty cycle of the PWM signal is set through the Capture/Compare Register

(CCR). The PWM signal duty cycle is determined using equation (2).

Duty Cycle(%) =

CCR
Counter Period(ARR)

∗ 100 (2)

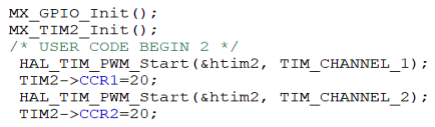
[picture p31: figure]

Figure 2.4.1 STM32 TIM2 CCR configuration

3.OPTOCOUPLER AND IGBT DRIVING

The optocoupler provides galvanic isolation between the high-voltage power circuit

and the low-voltage control circuit, enabling signal transmission without direct electrical

connection between the two circuits. This protects the control circuit from high voltage, noise,

and interference present in the power circuit. Additionally, the optocoupler not only transmits

the control signal in an isolated manner but also amplifies the signal to deliver a strong and

stable output suitable for the gate driver circuit. This signal is then fed to the gate driver

(TLP250), which controls the IGBT gate to ensure safe and reliable switching. Thus, the

system’s safety is enhanced, and the device’s operational lifetime is prolonged.

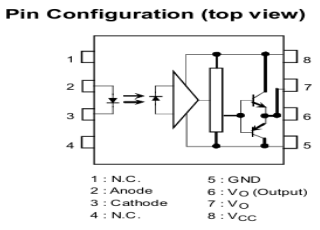
[picture p32: figure]

Figure 3.0.1 TLP 250 pin configuration

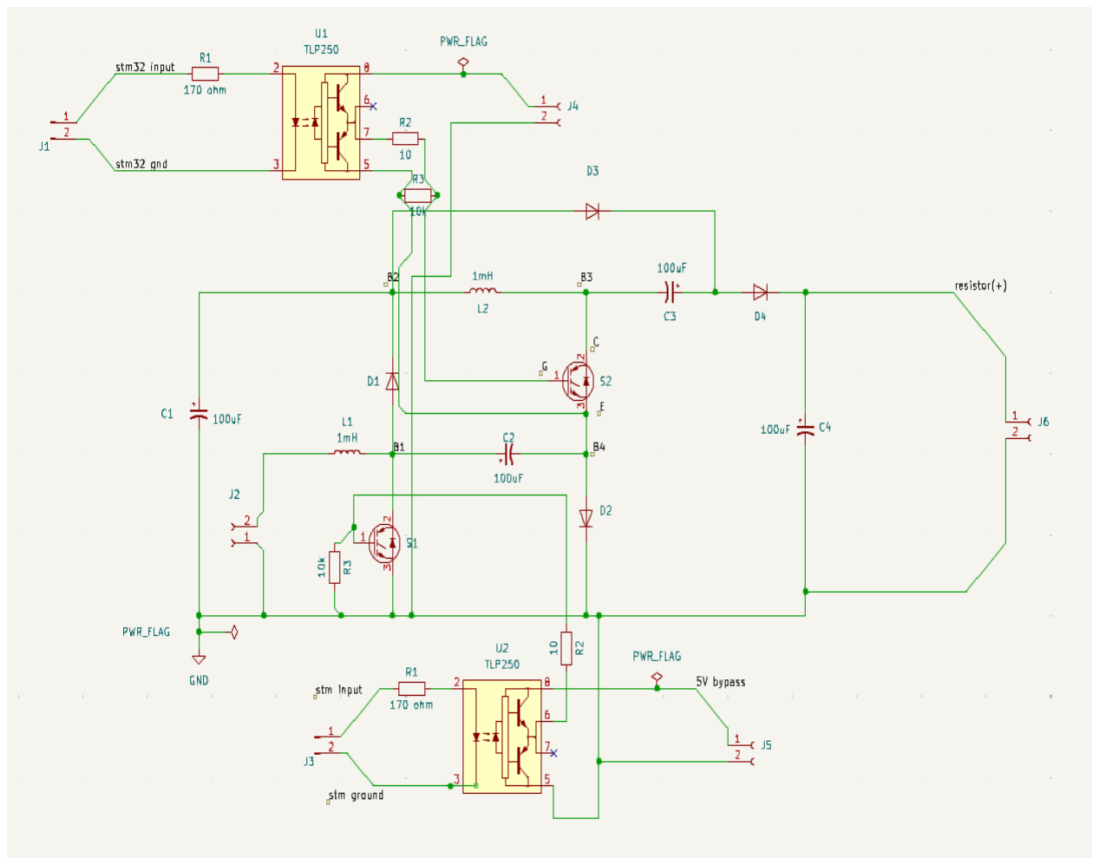
[picture p33: figure]

Figure 3.0.2 Detailed circuit diagram

R1 (170 Ω) is used to transmit the PWM signal from the STM32 microcontroller to

the input (pin 2) of the TLP250 optocoupler. This resistor is placed to limit the current flowing

through the internal LED inside the TLP250. The LED has a forward voltage drop of

approximately 1.6V. Since the recommended input current for the TLP250 is up to 11 mA, a

safe operating value of 10 mA is chosen. Accordingly, the value of R3 is calculated using

equation (3), based on the voltage difference between the supply voltage and the LED forward

voltage, and the desired current. This ensures that the internal LED operates safely and

efficiently.

(3.3 − 1.7)V = 0.01A × R1 (3)

R1 = 170Ω

R2 (10 Ω) is located between the TLP250's output (pin 6) and the gate of the

MOSFET. This resistor limits the current flowing into the gate, which can be very high during

fast switching due to the gate capacitance of the MOSFET. R4 helps suppress voltage spikes

and dampens switching noise, thereby reducing electromagnetic interference (EMI) and

preventing unwanted oscillations.

R3 (10k Ω) functions as a pull-down resistor connected to the gate line. Its role is to

keep the gate at a low level when no PWM signal is present. Without this resistor, the gate

could float and cause the MOSFET to unintentionally turn on. By ensuring that the gate is

pulled to ground when inactive, R5 enhances the stability and safety of the circuit.

### 4. POWER SUPPLY DESIGN FOR OPTOCOUPLERS AND CONVERTER

To operate the circuit properly, power must be supplied to both the optocoupler

inputs and the main circuit input. For this purpose, three separate power supply circuits were

designed: one for the circuit input and two for the gate drivers.

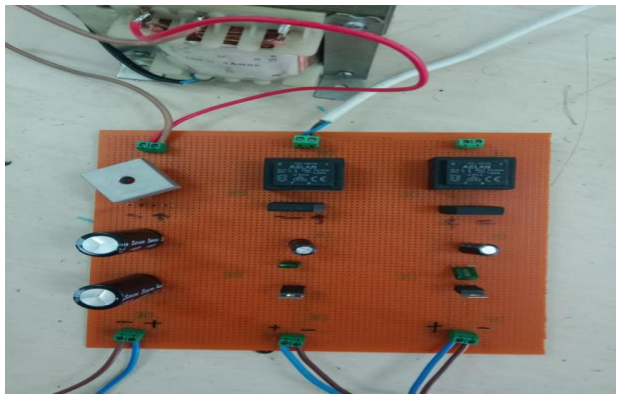
[picture p34: figure]

Figure 4.0.1 Power supply circuit

### 4.1 Power Supply Design for Circuit Input

The 220 V AC voltage from the mains is stepped down to 15 V using a transformer.

This 15 V AC voltage is then converted to DC using a bridge rectifier (KBPC 3510), resulting

in an output voltage of approximately 21.6 V DC. The rectified voltage is filtered using 35 V,

20,000 µF DC link capacitors to reduce ripple components and then supplied to the DC to DC

converter input. The required capacitance value for filtering was calculated using equation (4).

C =

I
f×∆V

(4)

In this equation, the current is I=2.4 , the frequency is f=100 Hz and the voltage

ripple is ΔV=1.2 V. The required capacitance value is selected as C=20 000 μF.

The 21.6 V DC voltage obtained after rectification and filtering drops to

approximately 18 V when connected to the converter circuit. This voltage drop is caused by

voltage regulation effects, including the winding impedance voltage drop of transformer due

to the current demand of the connected load.

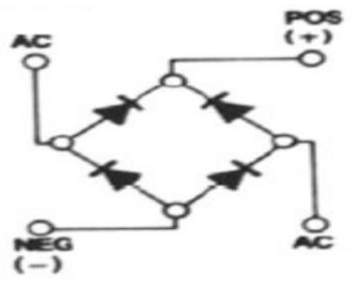
[picture p35: figure]

Figure 4.1.1 KBPC 35 bridge rectifier

### 4.2 Power Supply Design for Optocouplers

To operate the optocouplers (TLP250), a supply voltage between 10–35 V must be

applied to pin 8 (VCC). To meet this requirement, a linear power supply circuit was designed.

The 220 V AC voltage from the mains is first stepped down to 12 V AC using a

transformer (ASL102112). The resulting 12 V AC voltage is then rectified by a bridge rectifier

diode (KBU4M) to approximately 17 V DC. The rectified voltage is filtered using a DC link

capacitors and then regulated to a stable 12 V DC using a KA7812 linear voltage regulator.As

a result, the obtained 12 V DC voltage is applied to pin 8 (VCC) of the TLP250 optocouplers

as the supply voltage. Since the TLP250 optocouplers can provide a maximum output current

of 1.5 A, a 10-ohm resistor is connected to pin 6 of the optocoupler to limit the output current.

In this way, the output current is maintained at approximately 1.2 A, ensuring safe operation.

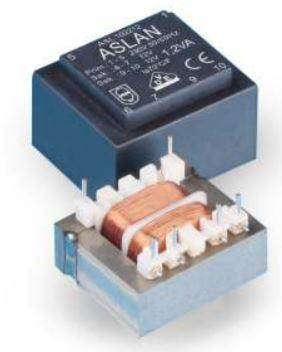
[picture p36: figure]

Figure 4.2.1 ASL102112 transformer

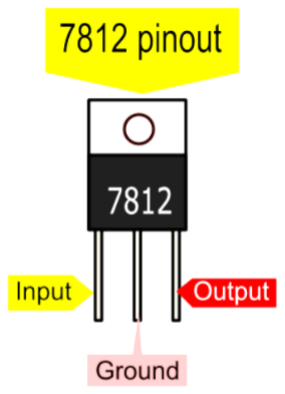
[picture p37: figure]

Figure 4.2.2 KA7812 linear voltage regulator

### 5. THEORETICAL RESULTS, SIMULATION AND EXPERIMENTAL RESULTS

### 5.1 Theoretical Results

By applying a positive VGE voltage to the gate terminals of switches S1

and S2, the switches turn ON. In this mode, L1 and L2 store energy, and the inductor

currents increase with the energy coming from capacitors C1 and C2. Diodes D1, D2,

and D0 are in cutoff due to reverse bias, while D3 is conducting. During this period,

since D0 is in cutoff, the load is supplied by C0.

Since a positive VGE voltage is not applied to the gate terminals of switches

S1 and S2, both switches remain OFF, and diodes D1, D2, and D0 conduct due to

forward bias. The stored energy is transferred to the load by capacitors C1 and C2.

During this period, diode D0 becomes forward-biased, and capacitor C3 supplies

energy to the output circuit.

The output voltage is as expressed as a function of input voltage and a

quadratic gain factor by Equation (5).

Vo = Vi ×

(3 − D)
(1 − D)

2

(5)

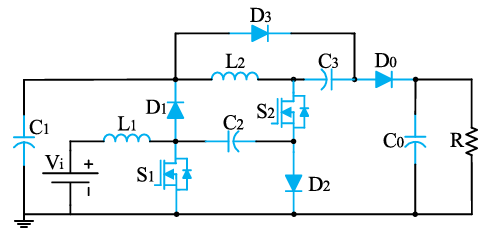
[picture p38: figure]

Figure 5.1.1 Schematic diagram of the DC to DC boost converter

When Vi=18V, the output voltage values are computed from the equation above and tabulated

below at different duty cycles.

Table 5.1.1 Theoretical Vo– Duty Cycle relationship

Duty Cycle(D) | Vo(Volt)
D=0.01 | 54.91 V
D=0.02 | 55.85 V
D=0.03 | 56.81 V
D=0.05 | 58.83 V
D=0.1 | 64.44 V
D=0.2 | 78.75 V
D=0.3 | 99.18 V

The circuit diagram is shown in Figure 5.1.1 the output voltage obtained at different

duty cycles is shown in Table 5.1.1 and the output voltage obtained at different duty cycles is

shown in Figure 5.1.2 as a graph.

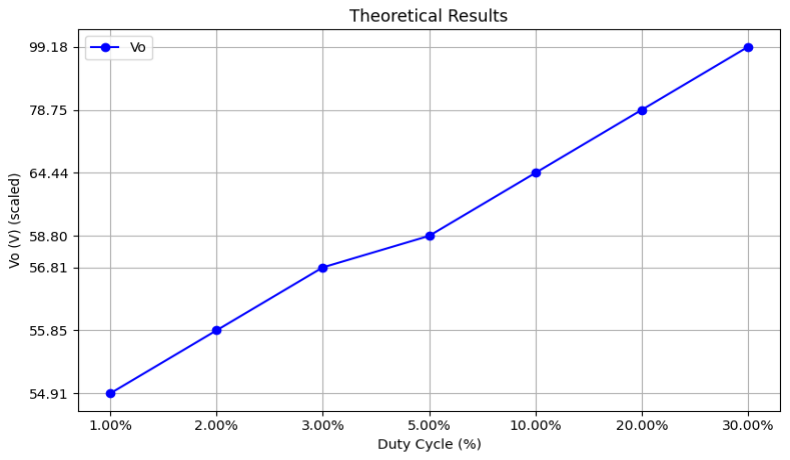
[picture p39: figure]

Figure 5.1.2 Theoretical Vo– Duty Cycle relationship with graph

### 5.2 Simulation Results

The proposed converter circuit was modeled in the MATLAB/Simulink

environment, and the output voltage (V₀) was analyzed. In the simulation, the input voltage

was kept constant at 18 V, and the output voltage was observed under different duty cycles

(D).

The results show that as the duty cycle increases, the output voltage also increases

significantly. For example, when D = 0.2, the output voltage was approximately 75.5 V; when

D = 0.3, it increased to about 94.2 V.

These values are in good agreement with the theoretical voltage gain equation (1),

confirm that the proposed converter provides ultra-high voltage gain across different duty

cycles.

The resulting values are written in Table 5.2.1. The oscilloscope results obtained as

a result of the experiment are shown in Table 5.2.2. In Figure 5.2.3 the results obtained at

different duty cycles are shown graphically. The circuit drawn in the simulation is shown in

Figure 5.2.1.

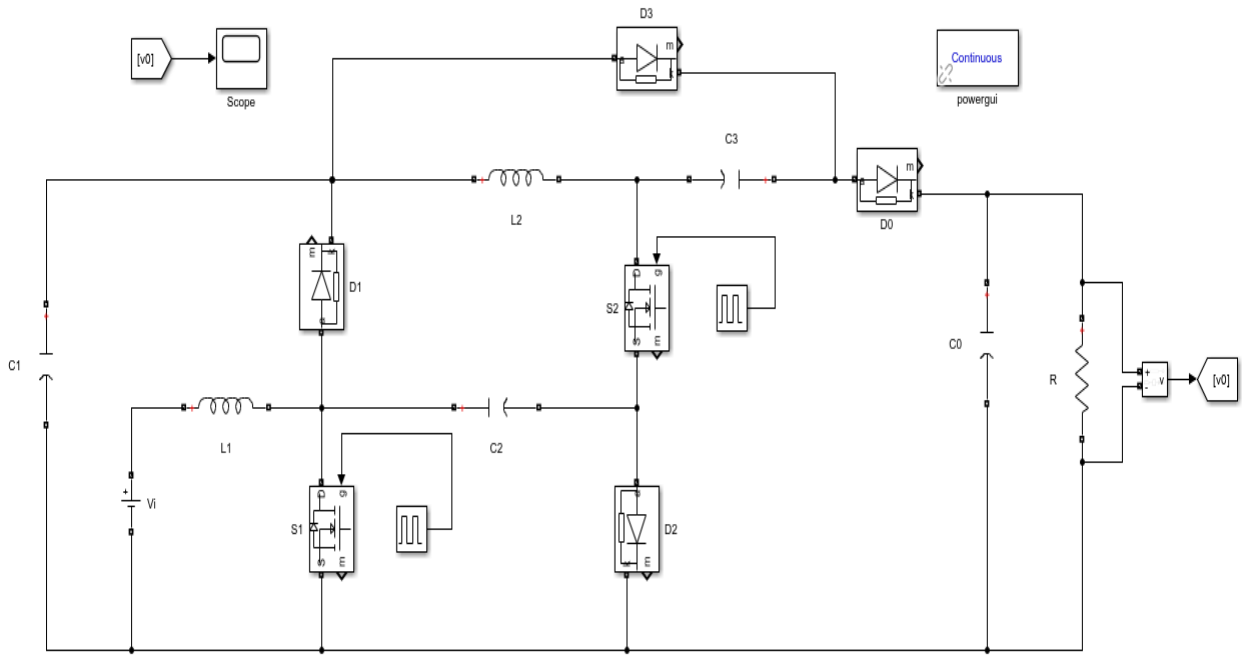
[picture p40: figure]

Figure 5.2.1 Simulation of the converter

Table. 5.2.1 Simulation Vo– Duty Cycle relationship

Duty Cycle(D) | Vo(Volt)
D=0.01 | 44.80 V
D=0.02 | 49.90 V
D=0.03 | 52.40 V
D=0.05 | 55.60 V
D=0.1 | 61.90 V
D=0.2 | 75.50 V
D=0.3 | 94.20 V

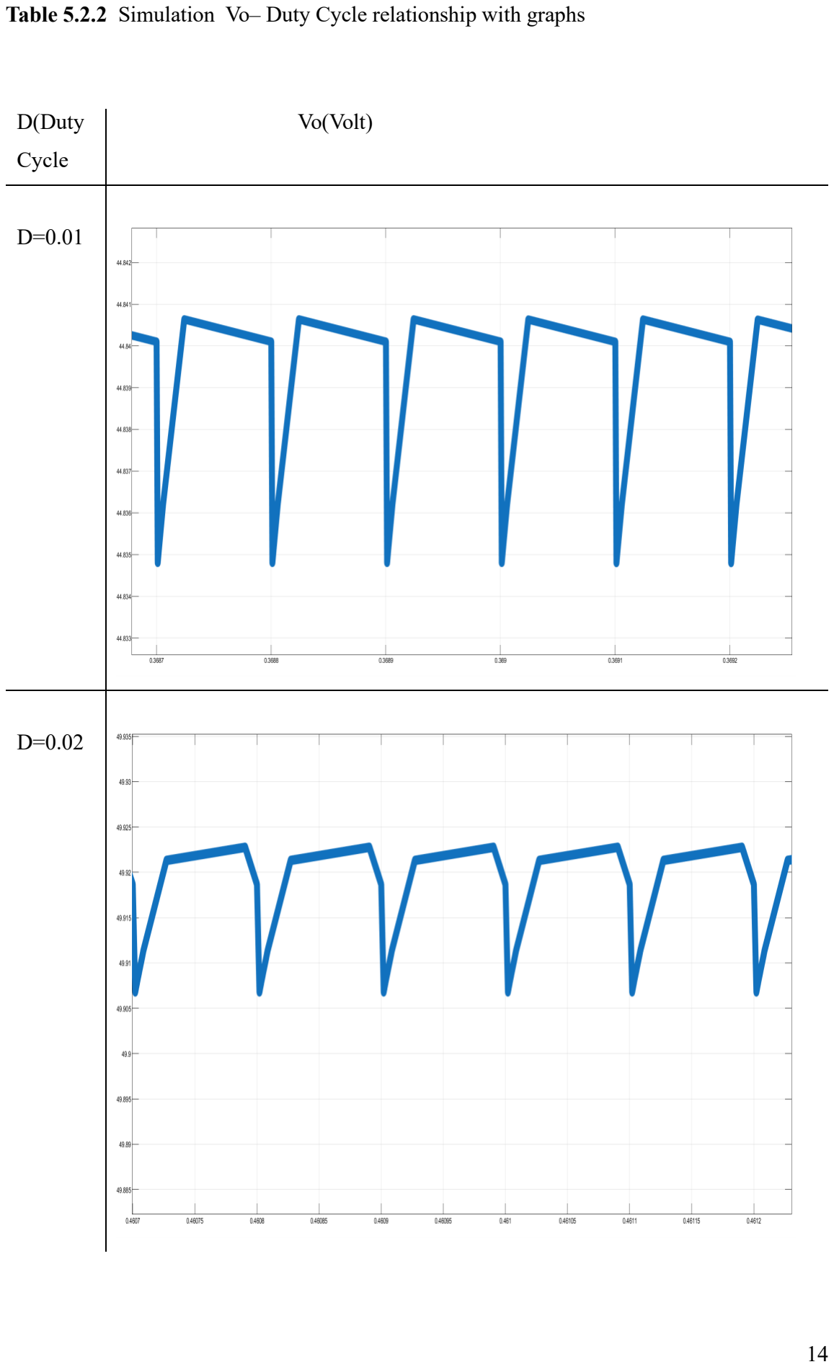
[picture p41: page 21]

Table 5.2.2 Simulation Vo– Duty Cycle relationship with graphs

D(Duty

Cycle

Vo(Volt)

D=0.01

D=0.02

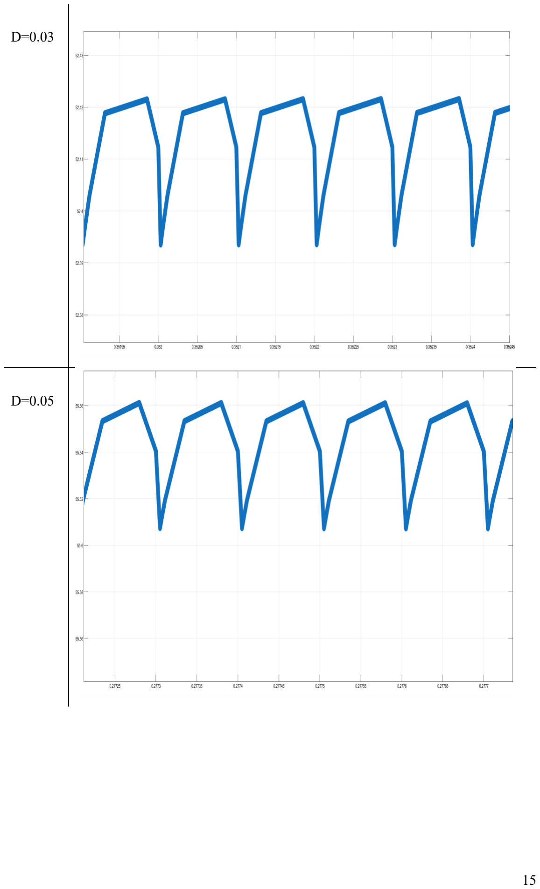
[picture p42: page 22]

D=0.03

D=0.05

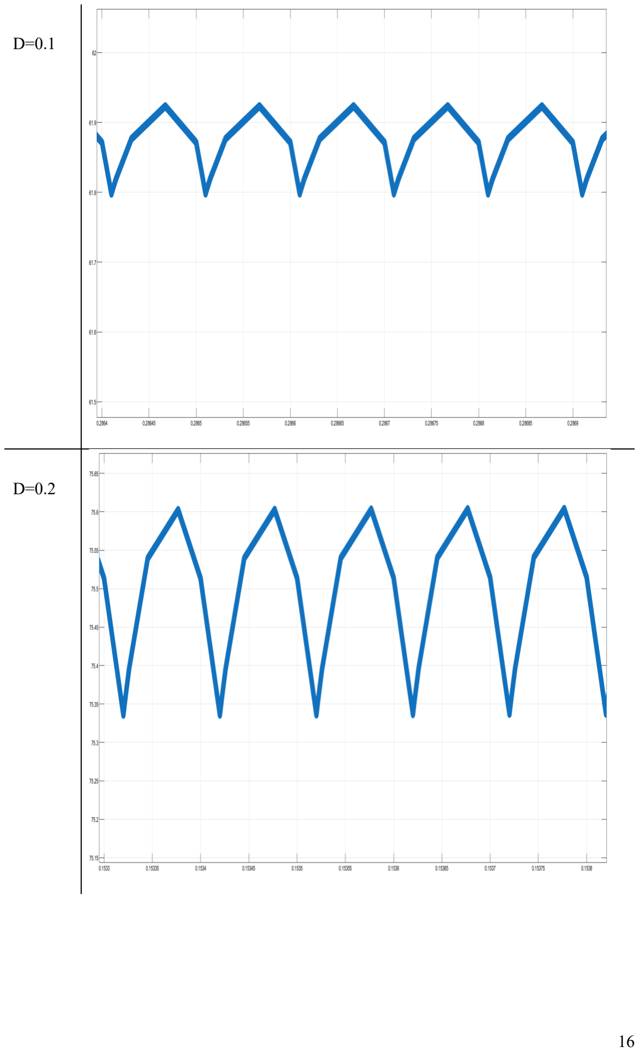
[picture p43: page 23]

D=0.1

D=0.2

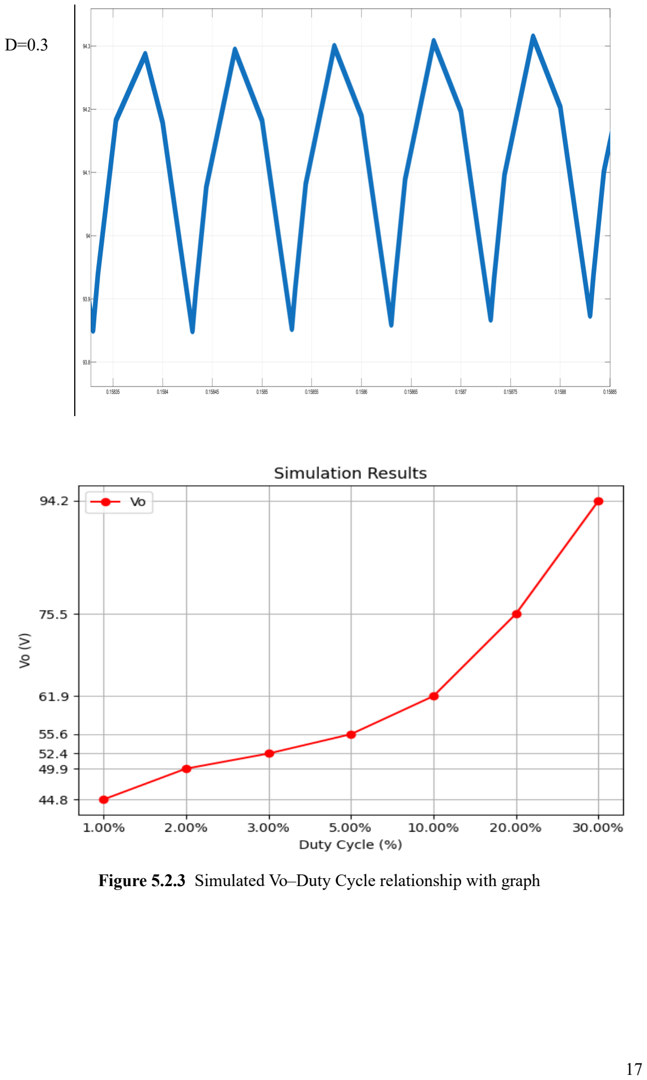
[picture p44: page 24]

D=0.3

Figure 5.2.3 Simulated Vo–Duty Cycle relationship with graph

### 5.3 Experimental Results

In this project, the circuit prototype was built, and the output voltage was observed

at different duty cycle (D) values. A difference of approximately 20% was identified between

the experimental and theoretical results. The main reason for this discrepancy is that the

theoretical calculations are based on ideal circuit component’s conditions (all component

resistances are neglected and actual switching characteristics of solid state devices are ignored

and ideal models are used). Additionally, the use of a breadboard instead of a printed circuit

board (PCB), as well as factors such as the type of connecting wires, soldering quality, and the

amount of solder used, also contributed to the deviation in the measurement results. The

experimental results can be improved by implementing the circuit on a PCB.

At duty cycle values lower than 0.03, the switching time becomes too short,

preventing the inductor and capacitors in the circuit from transferring sufficient energy. As a

result, the output voltage theoretically expected could not be achieved in practical applications.

The measured values are written in Table 5.3.1. The oscilloscope results obtained as

a result of the experiment are shown in Table 5.3.2. In Figure 5.3.1. the results obtained at

different duty cycles are shown graphically. The prototype of the circuit is shown in Figure

5.3.2.

Table 5.3.1 Experimental Vo–Duty Cycle relationship

Duty Cycle(D) | Vo(Volt)
D=0.01 | 26.80V
D=0.02 | 36.80 V
D=0.03 | 42.00 V
D=0.05 | 48.80 V
D=0.1 | 53.20 V
D=0.2 | 63.60 V
D=0.3 | 74.00 V

Table 5.3.2 Experimental Vo–Duty Cycle relationship with oscilloscope results

Duty

Cycle(D)

Vo(Volt)

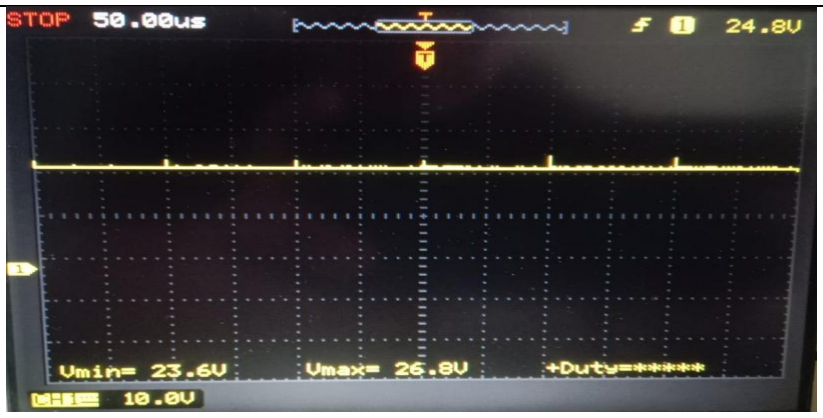
[picture p45: figure]

D=0.01

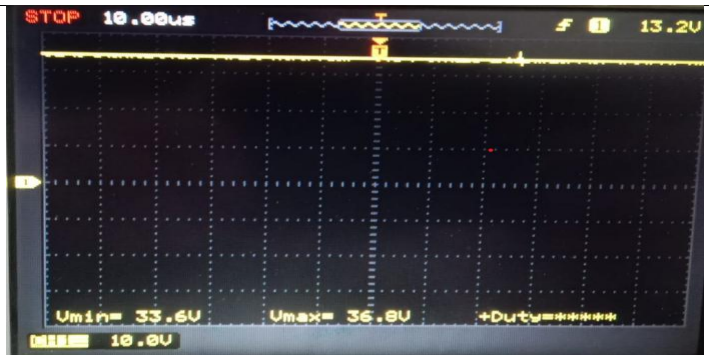
[picture p46: figure]

D=0.02

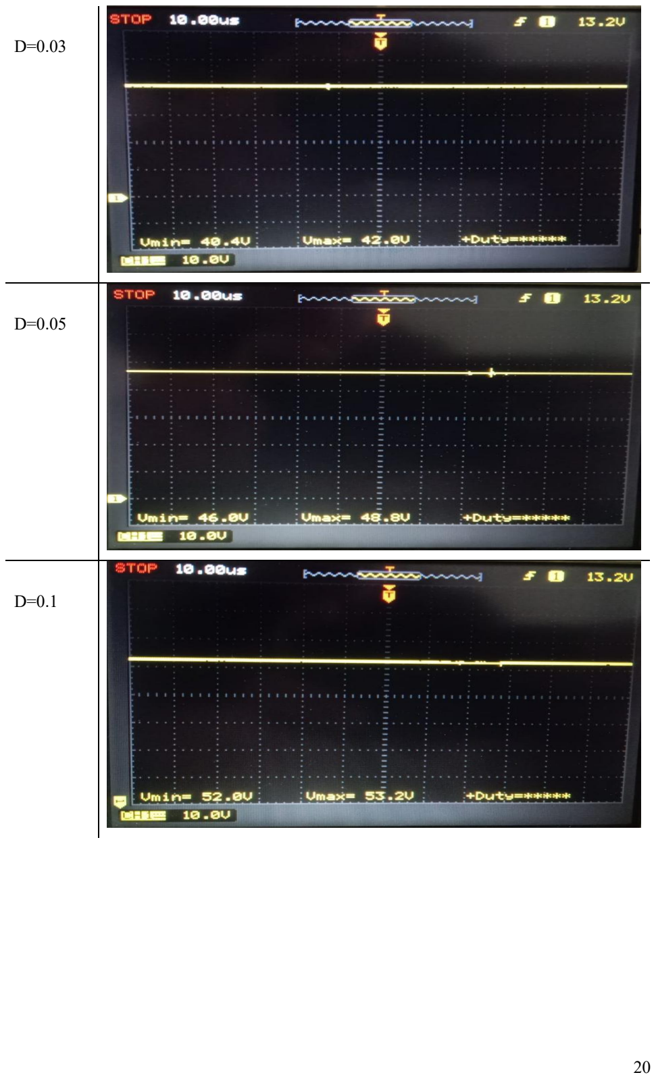
[picture p47: page 27]

D=0.03

D=0.05

D=0.1

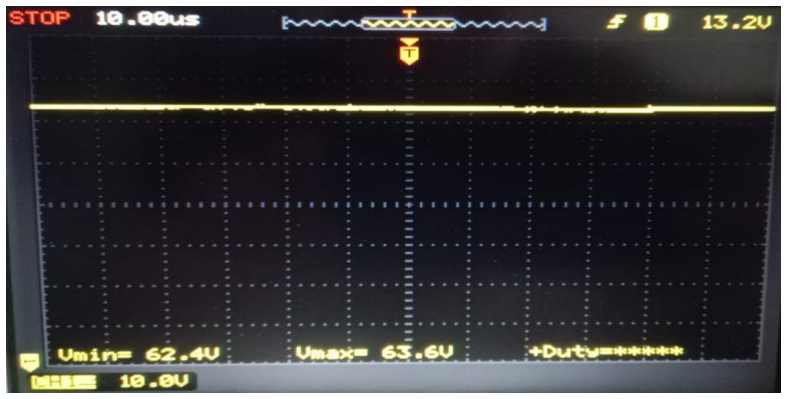
[picture p48: figure]

D=0.2

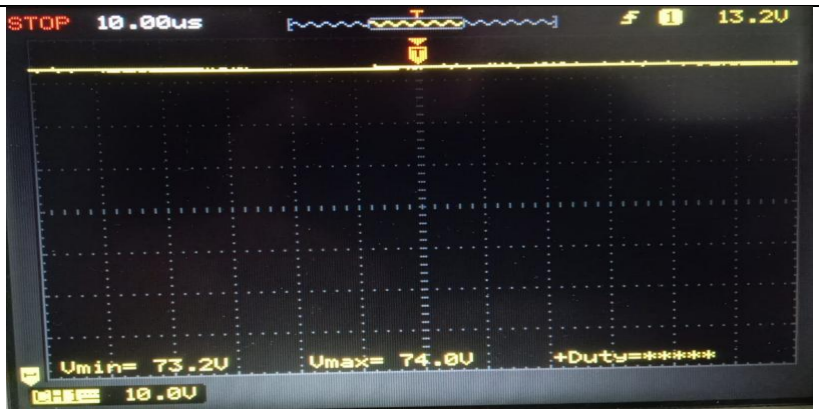
[picture p49: figure]

D=0.3

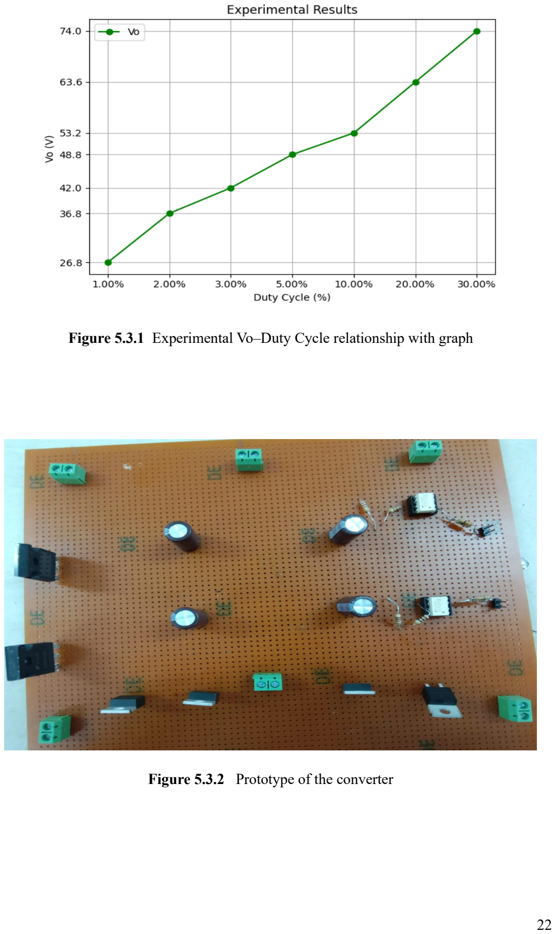
[picture p50: page 29]

Figure 5.3.1 Experimental Vo–Duty Cycle relationship with graph

Figure 5.3.2 Prototype of the converter

### 5.4 Comparison of Theoretical, Simulation, and Experimental Results

Theoretical, simulation, and experimental results are presented in Table 5.4.1. The

results obtained are illustrated graphically in Figure 5.4.1.

Table 5.4.1 Vo–Duty Cycle relationship comparison of theoretical, simulation and

experimental results.

Duty Cycle(D) | Theoretical Vo | Simulation Vo | Experimental Vo
D=0.01 | 54.91 V | 44.80 V | 26.80 V
D=0.02 | 55.85 V | 49.90 V | 36.80 V
D=0.03 | 56.81 V | 52.40 V | 42.00 V
D=0.05 | 58.80 V | 55.60 V | 48.80 V
D=0.1 | 64.44 V | 61.90 V | 53.20 V
D=0.2 | 78.75 V | 75.50 V | 63.60 V
D=0.3 | 99.18 V | 92.00 V | 74.00 V

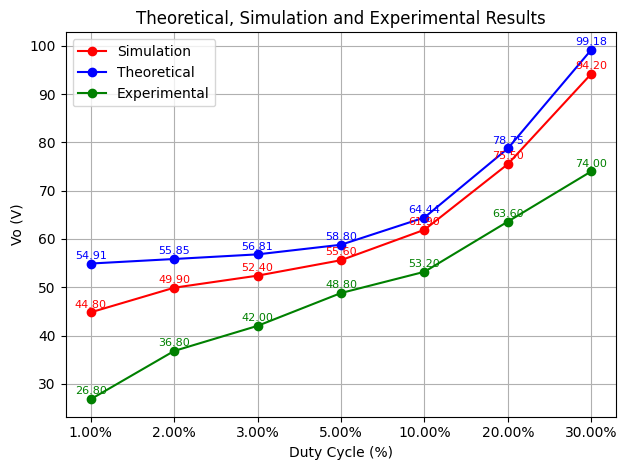
[picture p51: figure]

Figure 5.4.1 Vo–Duty Cycle relationship comparison of theoretical, simulation and

experimental results with graph.

### 5.5 Relationship Between Duty Cycle and Voltage Gain

In the circuit, as the duty cycle increases, both the output voltage and gain also

increase. However, the increase in duty cycle and output voltage leads to higher voltage and

current stresses on the circuit components. This necessitates the use of components with higher

current and voltage ratings, which in turn results in increased costs. Figure 5.5.1. shows the

relationship between gain and duty cycle graphically.

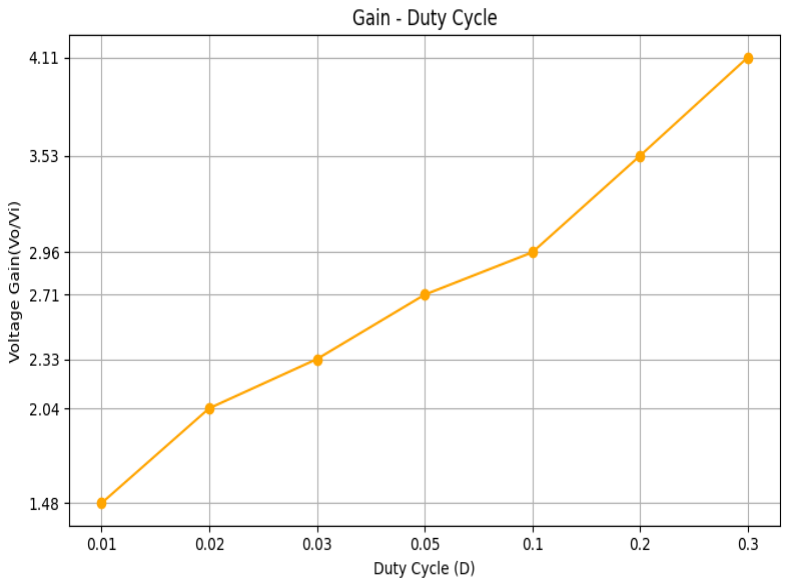
[picture p52: figure]

Figure 5.5.1 Gain -Duty Cycle relationship with graph

### 5.6 Experimental /Theoretical Result at Different Duty Cycles

Figure 5.5.2 shows the experimental/theoretical results obtained at different duty

cycle values graphically. According to the results obtained, when the duty cycle value falls

below 0.03, the ratio decreases because the inductors and capacitors cannot transfer enough

energy, and when the duty cycle value increases above 0.3, the losses increase due to the high

current and voltage on the elements and this ratio decreases. Therefore, the duty cycle value should be set between 0.03 and 0.3 so that the theoretical and experimental results are

compatible with each other.

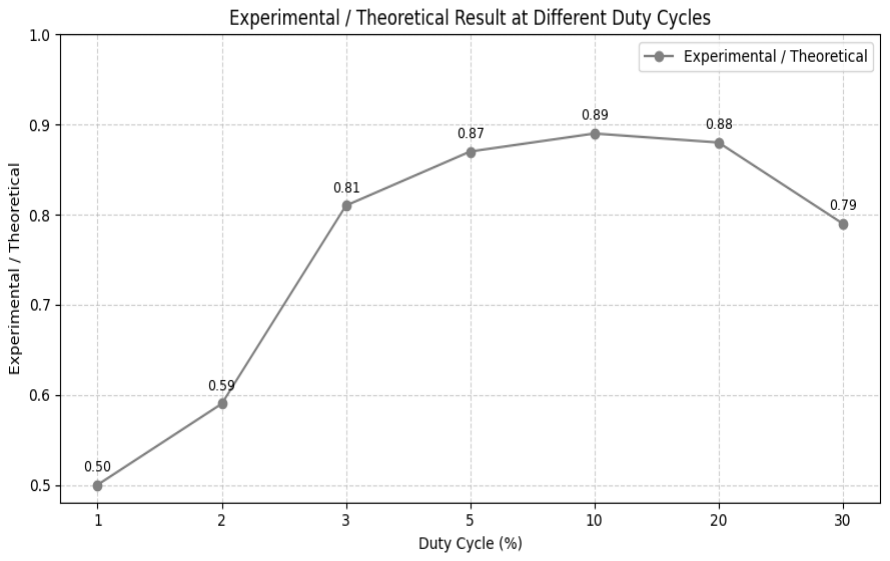
[picture p53: figure]

Figure 5.5.2 Experimental/Theoretical Result-Duty Cycle relationship

### 6. COST ANALYSIS:

Table 6.0.1 Cost analysis

HGTG20N60A4D IGBT (x2) | 300x2=600 TL
MUR 860 Diode (x4) | 26x4=104 TL
100V 100 µF Capacitor (x4) | 4x4=16 TL
Terminal block (x9) | 2x9=18 TL
TLP250 (x2) | 55x2=110 TL
10 ohm Resistor (x2) | 0.5x2=1 TL
170 ohm Resistor (x2) | 0.5x2=1 TL
10 kohm Resistor (x2) | 0.5x2=1 TL
100 ohm 50W Resistor | 60 TL
25V 10000 µF Capacitor(x2) | 38x2=76 TL
KBPC3510 Bridge Rectifier | 52 TL
ASL 102112 Transformer (x2) | 90x2=180 TL
150W Transformer | 1628 TL
KBU4M Bridge Rectifier (x2) | 16x2=32 TL
KA7812 Regulator (x2) | 40x2=80 TL
1 mH Inductor | 120 TL
500 µH Inductor | 120 TL
230 µF Capacitor(x2) | 2x2=4 TL
1 µF Capacitor(x2) | 1x2=2 TL
| Total= 3205 TL

7.CONCLUSION:

In this project, the quadratic DC-DC converter was first analyzed theoretically and

the relationship between input and output voltages was obtained. In the next stage, the circuit

is simulated in MATLAB/Simulink environment and it is observed that the simulation results

obtained are nearly consistent with the theoretical analysis. Then, the prototype of the circuit

was designed and implemented in the laboratory. In this process, the STM32F407

microcontroller was used to generate the PWM signals used in the circuit. The PWM signals

generated by the microcontroller were passed through TLP250 optocouplers to increase the

voltage levels and control the IGBTs in the circuit. In order to supply the power to TLP250

optocouplers and converter circuit, energy is taken from the grid. This voltage is converted to

the desired levels using transformers and various components using the designed power supply

circuit. After the prototype circuit was built, experimental studies were carried out and results

were obtained. The obtained theoretical, simulation and experimental data are compared and

shown in tables and graphs. The effect of duty cycle on circuit gain is also analyzed in detail

and the results are shown in tables and graphs. The reasons for the differences between the

experimental and theoretical results are discussed. Finally, the cost analysis of the circuit is

done and the cost of each component used is given in detail in a table. This circuit can be

further improved and more gain can be achieved with high voltage and current rated

components.

### 8. REFERENCES

[1] An Improved Non-Isolated Quadratic DC–DC Boost Converter With Ultra High Gain

Ability NAFIS SUBHANI 1,ZAZILAH MAY 2,(Graduate Student Member, IEEE), MD.

KHORSHED ALAM, IRFAN KHAN 4,(Senior Member, IEEE), MD. ALAMGIR HOSSAIN

5, AND SABRINA MAMUN 6

[2] S.V. K. Naresh, S. Peddapati, and M. L. Alghaythi, ‘‘Non-isolated high gain quadratic

boost converter based on Inductor’s asymmetric input volt age,’’ IEEE Access, vol. 9, pp.

162108–162121, 2021

[3] T.Rahimi,L.Ding,H.Gholizadeh,R.S.Shahrivar,andR.Faraji,‘‘Anultra high step-up DC–

DC converter based on the boost, Luo, and voltage dou bler structure: Mathematical

expression, simulation, and experimental,’’ IEEE Access, vol. 9, pp. 132011–132024, 2021.

[4] K. Yari, S. H. Shahalami, and H. Mojallali, ‘‘A novel nonisolated buck boost converter

with continuous input current and semiquadratic volt age gain,’’ IEEE J. Emerg. Sel. Topics

Power Electron., vol. 9, no. 5, pp. 6124–6138, Oct. 2021.

[5]. Veerachary and M. R. Khuntia, ‘‘Design and analysis of two-switch based enhanced gain

buck–boost converters,’’ IEEE Trans. Ind. Electron., vol. 69, no. 4, pp. 3577–3587, Apr. 2022.

[6] FAIRCHILD SEMİCONDUCTOR ,” 600V SMPS Series N-Channel IGBT with Anti

Parallel Hyperfast Diode,”, HGHG20N60A4D datasheet, Feb 2009

[7] TOSHİBA, ” Industrial Inverter Inverter For Air Conditioner IGBT Gate Drive Power

MOS FET Gate Drive,” TLP250 datasheet, May 2017

[8] FAIRCHILD SEMİCONDUCTOR, ” 8A, 400V - 600V Ultrafast Diodes,” MUR860

datasheet , Jan 2002

[8]A. Mahmood, M. Zaid, J. Ahmad, M. A. Khan, S. Khan, Z. Sifat, C.-H. Lin, A. Sarwar, M.

Tariq, and B. Alamri, ‘‘A non-inverting high gain DC–DC converter with continuous input

current,’’ IEEE Access, vol. 9, pp. 54710–54721, 2021

[9]R. Afzal, Y. Tang, H. Tong, and Y. Guo, ‘‘A high step-up integrated coupled

inductorcapacitor DC–DC converter,’’ IEEE Access, vol. 9, pp. 11080–11090, 2021

[10]P. Kumar and M. Veerachary, ‘‘Z-network plus switched-capacitor boost DC–DC

converter,’’ IEEE J. Emerg. Sel. Topics Power Electron., vol. 9, no. 1, pp. 791–803, Feb. 2021

[11]N. A. Ahmed, B. N. Alajmi, I. Abdelsalam, and M. I. Marei, ‘‘Soft switching multiphase

interleaved boost converter with high voltage gain for EV applications,’’ IEEE Access, vol.

10, pp. 27698–27716, 2022.

[12]S. Sadaf, M. S. Bhaskar, M. Meraj, A. Iqbal, and N. Al-Emadi, ‘‘A novel modified

switched inductor boost converter with reduced switch volt age stress,’’ IEEE Trans. Ind.

Electron., vol. 68, no. 2, pp. 1275–1289, Feb. 2021.
