erenozgurdogan/HighGain_DC-DC_Converter/converterschematic.png

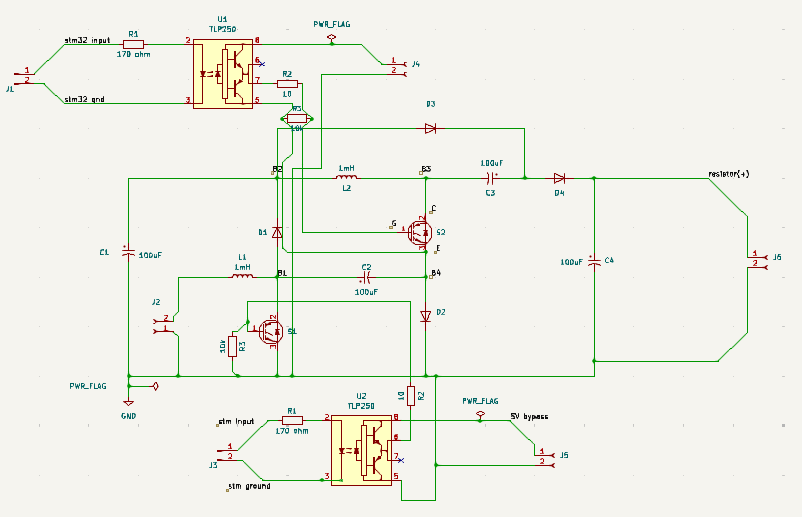
converterschematic.png
