erenozgurdogan/HighGain_DC-DC_Converter/Images/Gain/Gain-DutyCycle.png

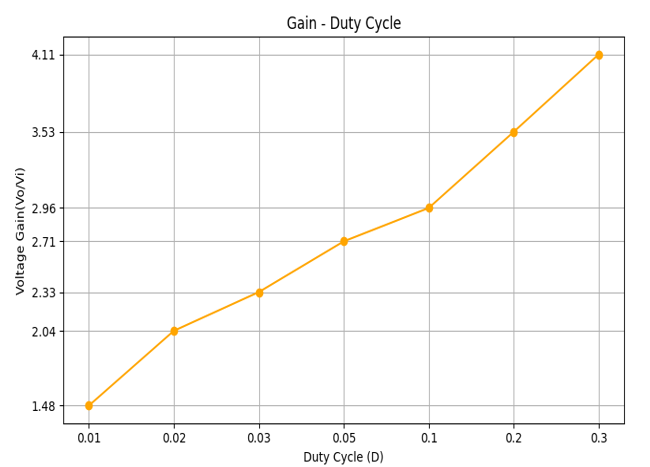
Images/Gain/Gain-DutyCycle.png
