erenozgurdogan/HighGain_DC-DC_Converter/Images/ Theoretical Results/TheoreticalResults.png

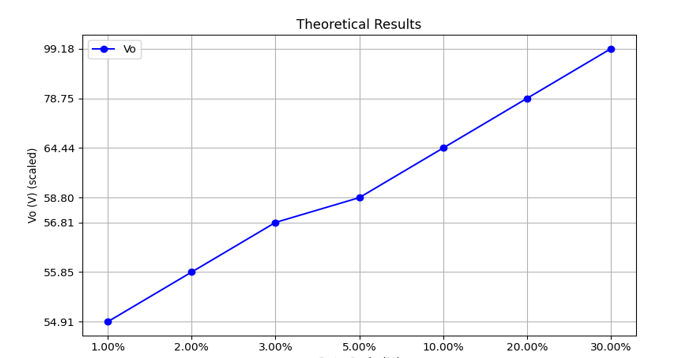
Images/ Theoretical Results/TheoreticalResults.png
