erenozgurdogan/HighGain_DC-DC_Converter/Images/ExperimentalResults/ExperimentalResults.png

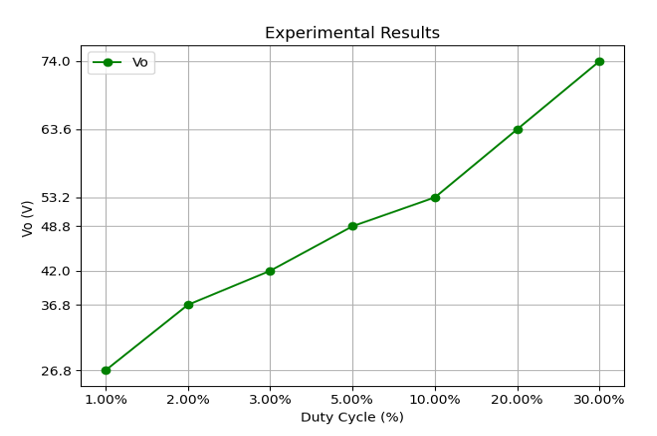
Images/ExperimentalResults/ExperimentalResults.png
