erenozgurdogan/HighGain_DC-DC_Converter/Images/SimulationResults/simulationresult.png

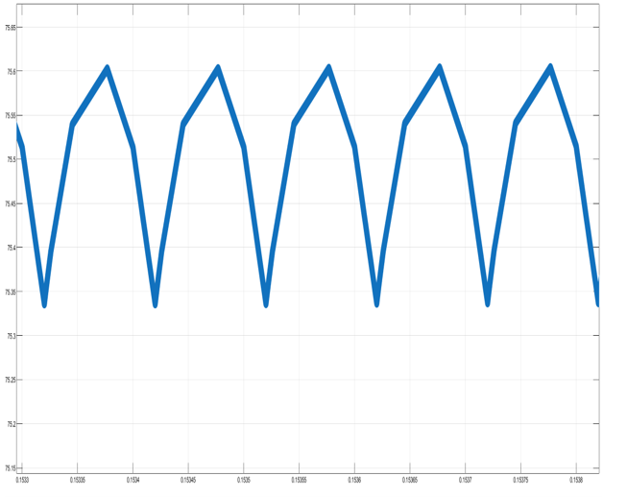
Images/SimulationResults/simulationresult.png
