erenozgurdogan/HighGain_DC-DC_Converter/Images/SimulationResults/simulationresults.png

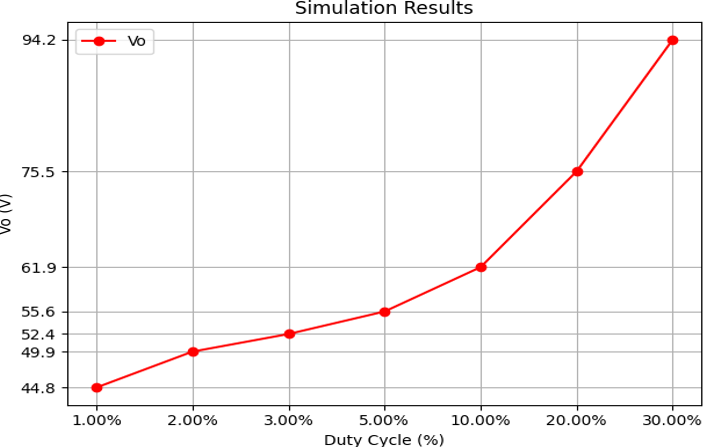
Images/SimulationResults/simulationresults.png
